TheMiz1os/WeatherStationV2/Project 3D Files and Models/adafruit-veml-7700-light-sensor-breakout-board-1.snapshot.2/VEML7700.jpg

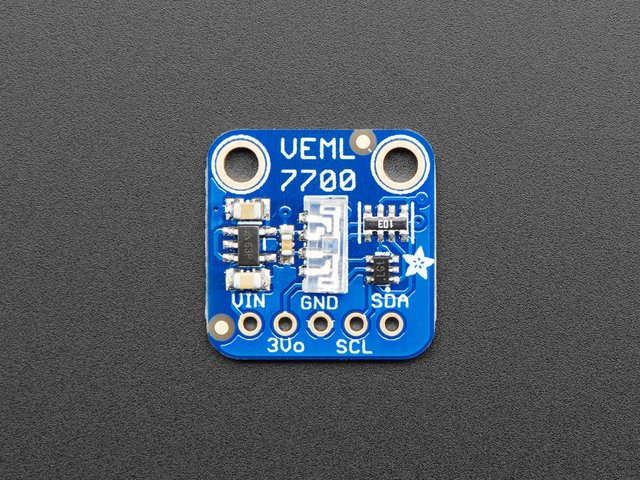
Project 3D Files and Models/adafruit-veml-7700-light-sensor-breakout-board-1.snapshot.2/VEML7700.jpg
