TheMiz1os/WeatherStationV2/Image References/Screenshot 2026-02-13 201124.png

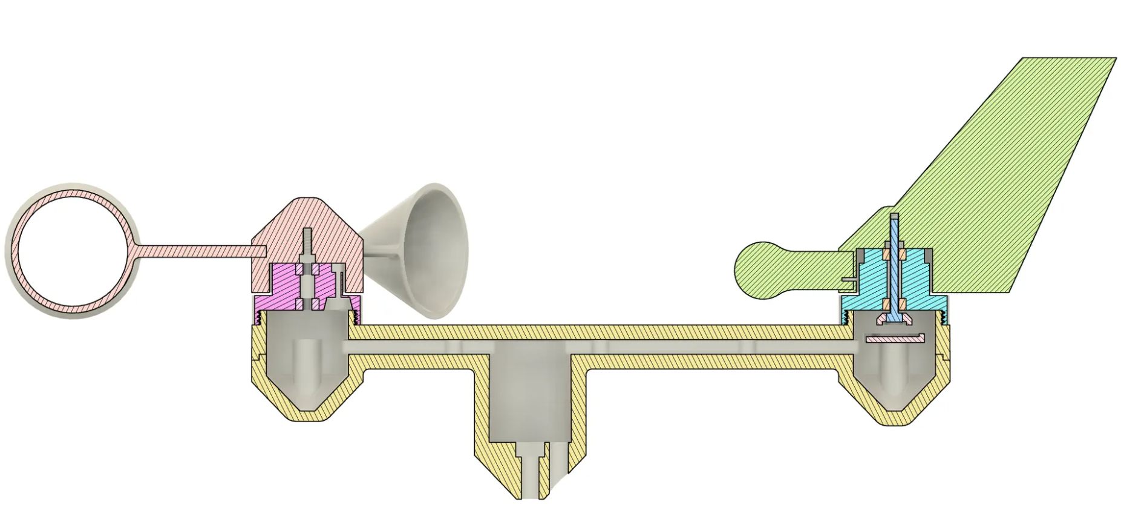
Image References/Screenshot 2026-02-13 201124.png
