TheMiz1os/WeatherStationV2/Project 3D Files and Models/weather-station-one-part-5/61764-weather-station-one-part-5.pdf

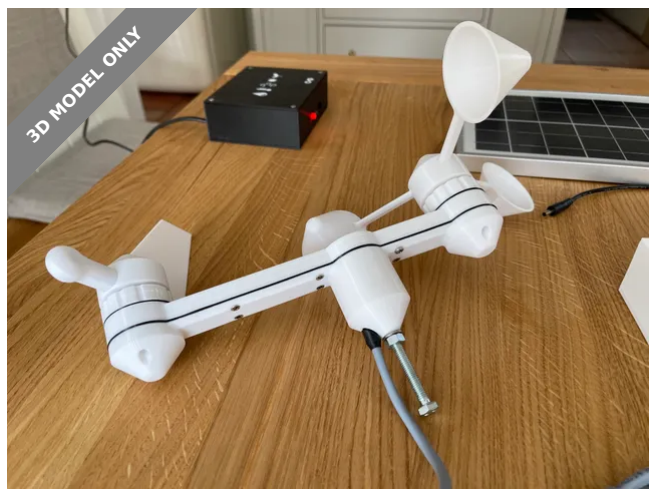
[picture p3: figure]
3D MODEL ONLY

## Summary

This is part 5 of a complete and modular weather station project. This is the wind vane and anemometer gauge part.

Gadgets (https://printables.com/model?categoryId=21) > Other Gadgets (https://printables.com/model?categoryId=43)

Tags: | sensor | temperature | humidity | wind | weather | rain
stevensonscreen | pressure | vane | anemometer | barometric

Overview on project

This is part of the Weather Station One project, a complete and modular weather station. The design of the system has been driven by a number of requirements:

collect all common weather channels including temperature, humidity, barometric pressure, rain, wind speed and direction, illumination / sun hours, ground humidity
modular design allowing one to implement part of it, or extend the range of sensors
high depth of production; DIY as much as possible

Harry (https://printables.com/@Harry)

## Weather Station One Part 5 - the Wind Vane and Anemometer

VIEW IN BROWSER (https://printables.com/model/61764-weather-station-one-part-5-the-wind-vane-and-anemo)

updated 1. 1. 2025 | published 1. 1. 2025

•

•

•

long range transmission support - with the point of measurement far from home
integration into a home automation system
functional, easy to print, and beautiful 3D design

When considering a project like this, please be aware that even with all designs published, it will be some work to do. This includes not only 3D printing, but carpentry work, soldering / electronics, and software in addition.

The parts published are made up from:

Part 1: Central Station. This is the part all sensors are connected to. It is battery / solar powered to allow placing it in the best place to measure data. It sends data collected using a HC-12 / 433Mhz band (up to 1 kilometer distance) chip.
Part 2: Base Station. This is the Central Station's counter part. It receives data using another HC-12 chip and is dispatching it to our home-automation system. In addition, it hosts a web server allowing direct access to weather data.
Part 3: Temperature (and other) sensor. This sensor is designed to sit in a proper Stevenson Screen / Wetterhütte. The current version measures ambient temperature, humidity, and barometric pressure using a digital sensor. It is connected to the Central Station.
Part 4: Rain Gauge. This is a rain gauge collecting rain and feeding it into commuting buckets. The number of commutes is measured using a reed contact triggered a bucket-moved magnet. It is connected to the Central Station.
Part 5: Wind Vane and Anemometer. Probably the most complex printing part measuring 16 wind directions and wind speed. Similar to the rain gauge, it is a mechanical part. Wind directions are measured using either 8 reed contacts, or an magnetic angle measurement sensor. Wind speed is measured by a single reed contact closed every time the anemometer wings do a full rotation. It is connected to the Central Station.
Part 6: Stevenson Screen / Wetterhütte. This part is not detailed further because we have built it based on a tutorial published by DWD (Deutscher Wetterdienst). As the tutorial has been removed from their site some time ago, you can find it as PDF file in Part 1: Central Station.
Part 7: optional Battery Pack. The solar module and charger chosen come with a mount for a 14500 sized Lithium battery. Depending on the power consumption of the Central Station (and sensors) you may want to use an external Battery Pack.
Part 8: Software and Electronics. This part is published on Github. (https://github.com/HarrysLapTimer/WeatherStationOne) Part 9: Solar Panel Mount. This is a solar panel mount as used currently. It allows adjusting the elevation to optimize generation for

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
Winter and Summer seasons. Mid term it will be replaced by a solar tracker following the sun azimuth.

For your convenience, I have created a WeatherStationOne (https://www.prusaprinters.org/social/92858-harry/collections/101642) collection including all but parts 6 and 8.

End of overview common to all parts.
Part 5 - Wind Vane and Anemometer

This combined sensor measures wind direction and wind speed.

19/2/2022 Update: added AS5600 Option

Wind direction using reeds

The initial version uses 8 reed contacts assembled as a ring to measure wind direction. A magnet moving with the vane triggers one, two, or three at a time. The two trigger situation in particular allows deriving 8 additional positions, resulting in 16 overall. So we do not only get N, NE, E, SE, S, SW, W, NW, but NNE, ENE, etc.

Using 8 reed contacts requires 8 wires plus one for VCC / GND contact. To reduce the number of wires, the electronic implementation adds a multiplexer chip into the wind mount. It allows Central Station to select one of the eight contacts, request its state, switch to the next and so on.

Overall, the multiplexing chip allows the reduction from 10 wires to 7 (see diagram), allowing us to utilize the 6 wire (plus shielding) cable we used throughout the project.

This option is named Reed Option in printing instructions.

New option! Wind direction using angle sensor

While the above version is working fine, mounting and soldering the 8 reed contacts on top of a multiplexer chip can be quite challenging. The second option presented here is based on a magnetic / inductive angle measurement sensor (AS5600) as proposed by a maker. It is the same low cost price class as the reeds and multiplexer.

The AS5600 features three interfaces, namely I2C, PWM, and analog output. While the former are better in general, they require more contacts and fine soldering (small contacts). As we use only 16 wind directions instead of degree or sub-degree measurements anyway, the current implementation uses the easy approach using the analog output and A2D conversion on the processing side.

This option is named the AS5600 Option in printing instructions.

Wind speed

Wind speed measurements using one reed is coming on top.

As most parts of Weather Station One, we use PETG filament. The 3D model includes seals to be printed using TPE or TPU filament. This is to keep the inner part of the wind sensors dry.

The anemometer requires calibration once it is assembled. The relation between axle rotations and wind speed can be set as a factor in the Central Station's ESP program.

Reed Option: handling 8 reed switches made of glass proved to be quite hard to keep functional during assembly. They need to be glued in and can break nevertheless. After two attempts to get a working combo, we switched to plastic body reeds. These are by far easier to handle and work fine.

AS5600 Option: this option requires hardware calibration; the magnet mount needs to be turned so the system reports North direction when VaneTip point to the N engraved in VaneMount. So the steps are: #1 glue magnet into MagnetMount, #2 press the mount on the screw - do not glue yet, #3 test direction and adjust mount, #4 once it matches, mark direction with a pencil and glue MagnetMount to the screw.

The wind mount has a M6 opening in the bottom to put it onto a threaded rod attached to the Stevenson Screen.

Printing configuration

Layer height 0.2mm
0.4mm nozzle
15% infill
White PETG filament
Black TPE / TPU filament
as shown in the PrusaSlicer files included, we this is printed in four jobs
job #1 - mount: turn the upper part upside down
job #2 - vane: place the tip of the vane vertical; tip with 100% for weight balancing; this job differs depending on whether Reed Option or AS5600 Option is implemented
job #3 - anemometer: print 3 cups, and place them with the open side down
job #4 - seals: as is
automatic support (from building plate only)

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
## Model files

Other parts needed

4x miniature steel bearing 3x8x4mm
2x long M3 screws or a M3 threaded rod to shorten for both axles 14x M3x10 screws
1x glass reed contact 2x14mm for anemometer (buy more, they break easily)
Reed Option: 8x plastic reed contacts 3x14mm for wind vane Reed Option: 1 x HC4051 multiplexer chip
2x magnet 4x1mm (buy some more for fine tuning)
AS5600 Option: 1x AS5600 sensor - version soldered to a “round” PCB
AS5600 Option: 1x diametrically magnetized neodymium magnet 8x1mm
cable to run from wind mount to central station, outer diameter 4.7mm
1x MiniDIN (PS/2) 6 pin plug (shielding used as 7th wire)
2x M6 nut for the base and as counter nut
1x M6 threaded rod to as a mount to the Stevenson Screen

Closing

This is another free 3D model made available for you. Designing, testing, preparing, uploading and maintaining my models is effort. In case you enjoy them, please send a donation using the coin button in the top right. Thanks a lot!

## This remix is based on

- PrusaSlicer file for job #4

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
windseals.3mf

- PrusaSlicer file for job #3
- PrusaSlicer file for job #2 for Reed Option
- PrusaSlicer file for job #2 for AS5600 Option
- PrusaSlicer file for job #1
- print 3 times
- used by Reed Option

anemometer.3mf

vanereedoption.3mf

vaneas5600option.3mf

windmount.3mf

windvaneseal.stl

anemoflyer.stl

mainseal.stl

vanereedmount.stl

anemoreedmount.stl

anemoflyersmount.stl

- Print with the flat side down and 100% infill (weight distribution)
- used by AS5600 Option
- used by AS5600 Option
- used by AS5600 Option

Find source .stl files on Thingiverse.com (http://downloads.gps-laptimer.de/WeatherStation.f3d)

## License

This work is licensed under a
Creative Commons (4.0 International License)

Attribution (http://creativecommons.org/licenses/by/4.0/)

vanetip.stl

vane.stl

windmountbottom.stl

windmounttop.stl

sensormount.stl

magnetmount.stl

vanemount.stl

✖ | Sharing without ATTRIBUTION
✔ | Remix Culture allowed
✔ | Commercial Use
✔ | Free Cultural Works
✔ | Meets Open Definition
