TheMiz1os/WeatherStationV2/3D Files/Main Assembly v28.3mf

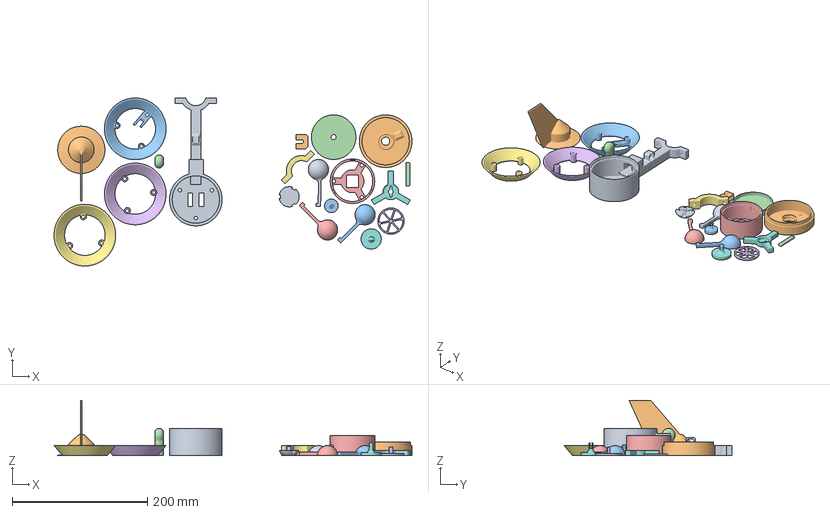
[picture p4: CAD file, 2026-01-24]
3D Files/Main Assembly v28.3mf
530.1 x 248.8 x 82.0 mm
Main Body
Top
Sensor Housing
Beaing Holder
Bowl 3
Vane
Bowl 2
VaneTip.stl
Bowl 1
Cunter-Holder
Shaft x 2
Cap
Magnet Holder
