TheMiz1os/WeatherStationV2/Project 3D Files and Models/cjmcu-680-bme680/CJMCU-680, BME680 Ambient Temperature, Relative Humidity, Barometric Pressure, and Gas VOC Sensor.SLDASM

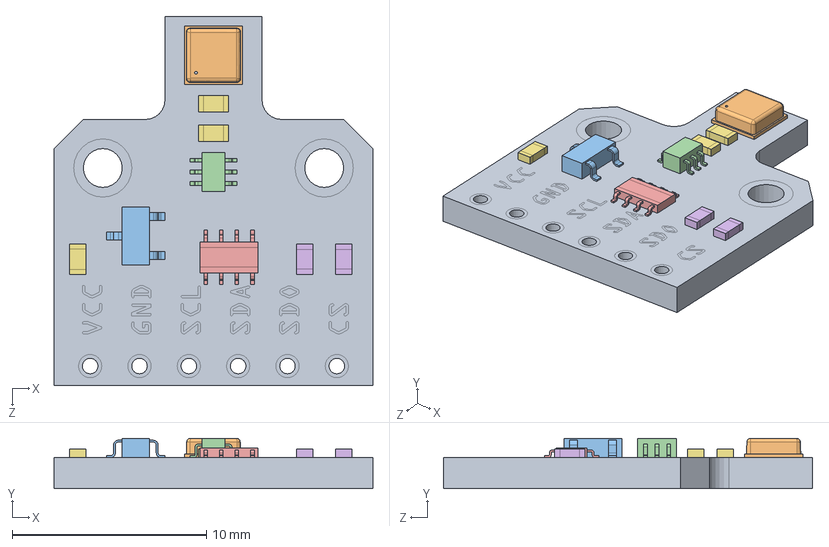
[picture p5: CAD file, 2026-01-24]
Project 3D Files and Models/cjmcu-680-bme680/CJMCU-680, BME680 Ambient Temperature, Relative Humidity, Barometric Pressure, and Gas VOC Sensor.SLDASM
16.4 x 2.60 x 19.0 mm
PCB, CJMCU-680, BME680 Ambient Temperature, Relative Humidity, Barometric Pressure, and Gas VOC Sensor
Sensor Module, CJMCU-680, BME680 Ambient Temperature, Relative Humidity, Barometric Pressure, and Gas VOC Sensor
3.3V LDO Regulator, CJMCU-680, BME680 Ambient Temperature, Relative Humidity, Barometric Pressure, and Gas VOC Sensor
Level Signal Conversion Chip, CJMCU-680, BME680 Ambient Temperature, Relative Humidity, Barometric Pressure, and Gas VOC Sensor
8 Legs SMD Component, CJMCU-680, BME680 Ambient Temperature, Relative Humidity, Barometric Pressure, and Gas VOC Sensor
SMD Resistor, Configurable, CJMCU-680, BME680 Ambient Temperature, Relative Humidity, Barometric Pressure, and Gas VOC Sensor x 2
SMD Capacitor, Configurable, CJMCU-680, BME680 Ambient Temperature, Relative Humidity, Barometric Pressure, and Gas VOC Sensor x 3
