TheMiz1os/WeatherStationV2/3D Models/SOT-23-6.step

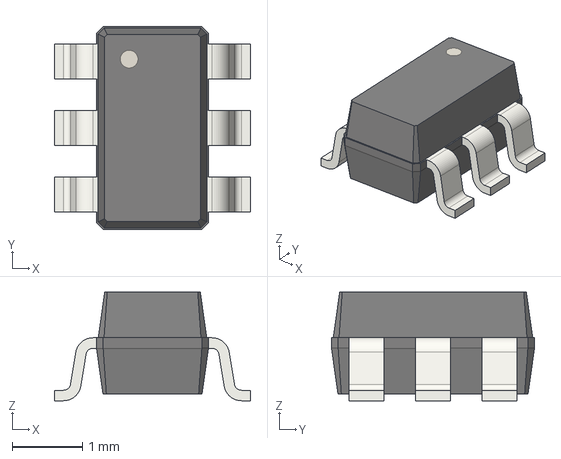
[picture p7: CAD file, 2026-08-27]
3D Models/SOT-23-6.step
2.80 x 2.90 x 1.55 mm
