TheMiz1os/WeatherStationV2/_Secondary board/Secondary Board.step

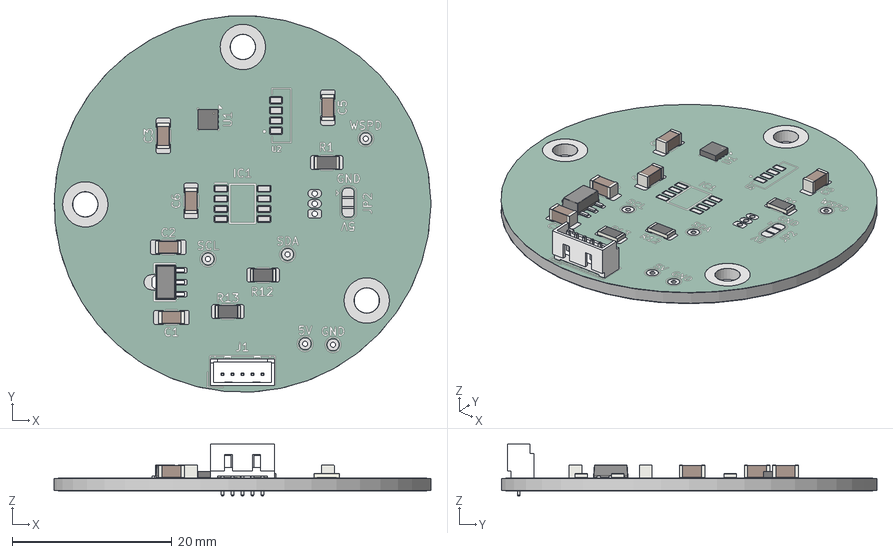
[picture p8: CAD file, 2026-02-16]
_Secondary board/Secondary Board.step
47.2 x 47.1 x 6.48 mm
JST - GH - Thru (V) - 5Pin - 1.25mm
R_1206_3216Metric x 3
C_1206_3216Metric x 5
SOT-89-3_L4.5-W2.5-P1.50-LS4.2-BR
Bosch_LGA-8_2.5x2.5mm_P0.65mm_ClockwisePinNumbering
Secondary Board_copper
Secondary Board_pad
Secondary Board_via
Secondary Board_silkscreen x 2
Secondary Board_soldermask x 2
Secondary Board_PCB
