TheMiz1os/WeatherStationV2/Project 3D Files and Models/adafruit-veml-7700-light-sensor-breakout-board-1.snapshot.2/Adafruit VEML 7700 Light Sensor Breakout Board.STEP

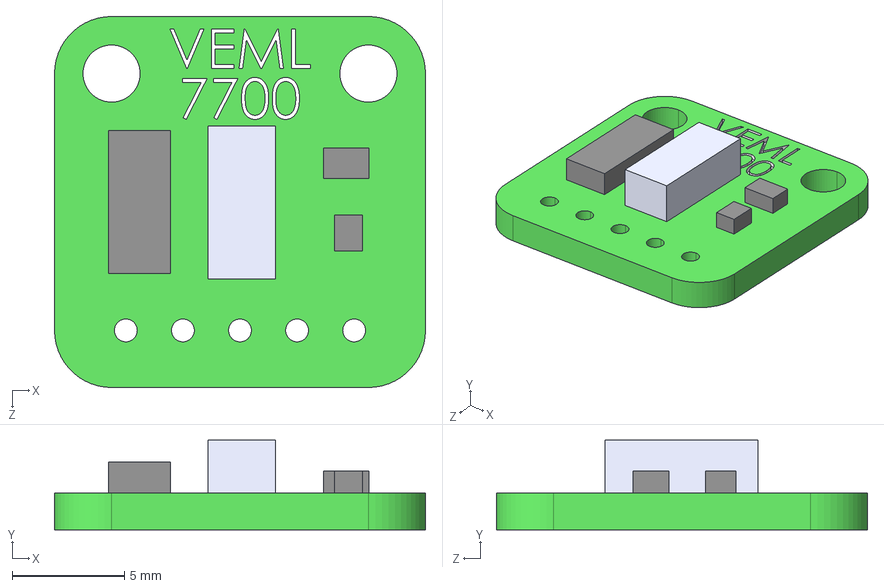
[picture p9: CAD file, 2026-02-12]
Project 3D Files and Models/adafruit-veml-7700-light-sensor-breakout-board-1.snapshot.2/Adafruit VEML 7700 Light Sensor Breakout Board.STEP
16.5 x 4.00 x 16.5 mm
