TheMiz1os/WeatherStationV2/Project 3D Files and Models/cjmcu-680-bme680/SMD Resistor, Configurable, CJMCU-680, BME680 Ambient Temperature, Relative Humidity, Barometric Pressure, and Gas VOC Sensor.SLDPRT

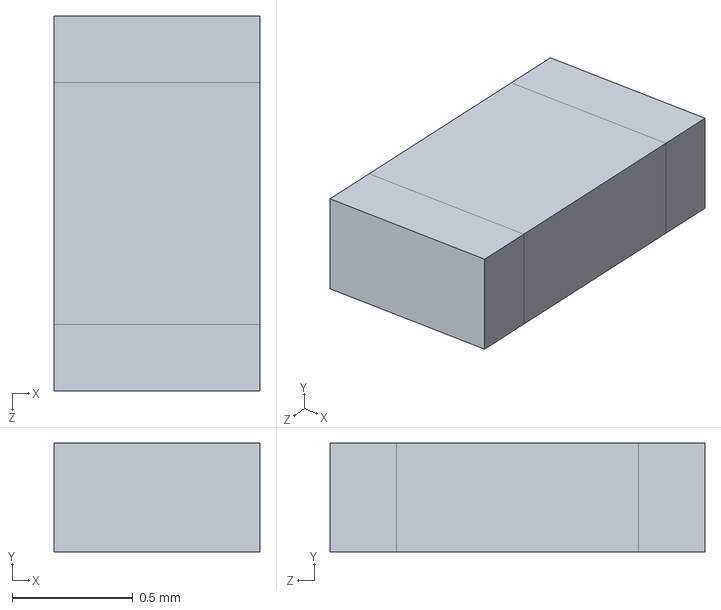
[picture p10: CAD file, 2026-01-24]
Project 3D Files and Models/cjmcu-680-bme680/SMD Resistor, Configurable, CJMCU-680, BME680 Ambient Temperature, Relative Humidity, Barometric Pressure, and Gas VOC Sensor.SLDPRT
0.85 x 0.45 x 1.55 mm
