TheMiz1os/WeatherStationV2/Project 3D Files and Models/weather-station-one-part-5/Vane.stl

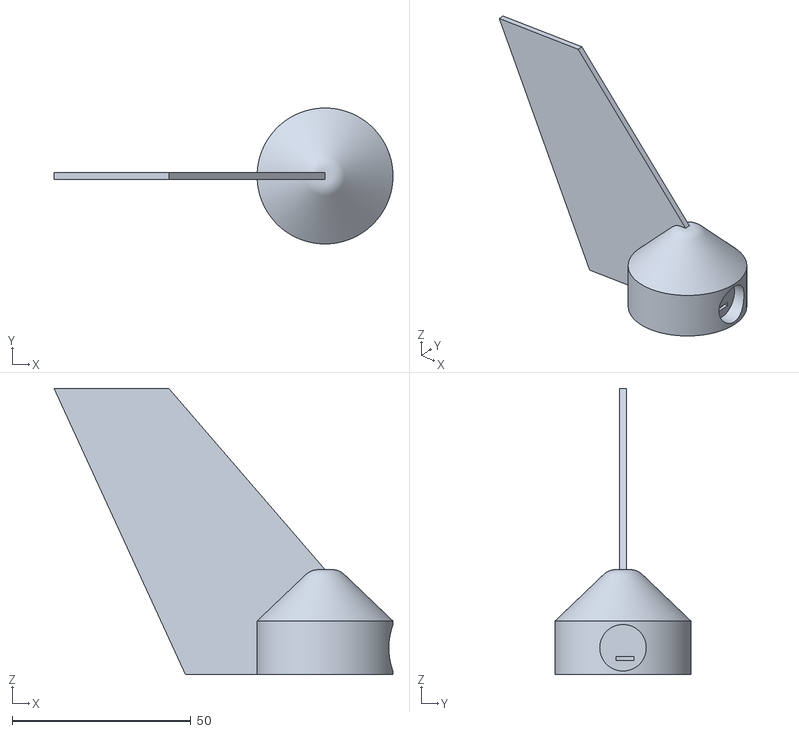
[picture p12: CAD file, 2026-01-24]
Project 3D Files and Models/weather-station-one-part-5/Vane.stl
94.8 x 38.0 x 80.0
