TheMiz1os/WeatherStationV2/Project 3D Files/board.step

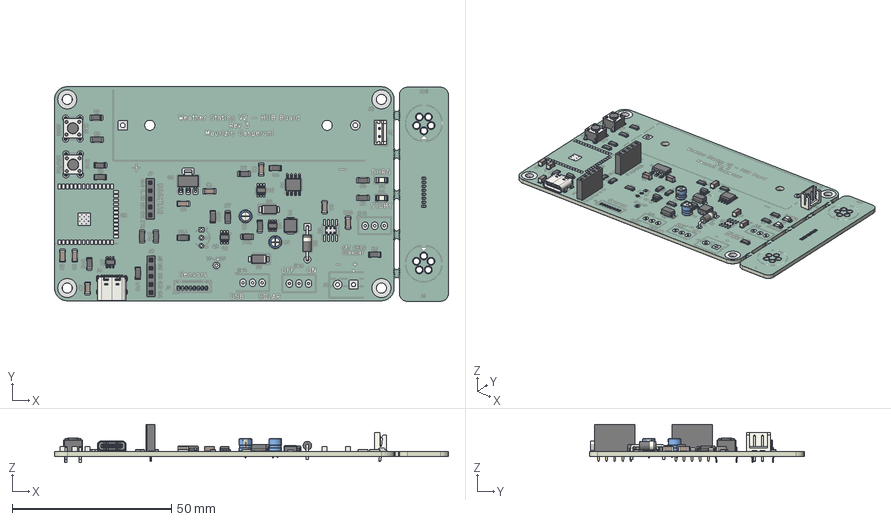
[picture p13: CAD file, 2026-10-16]
Project 3D Files/board.step
123.5 x 67.3 x 12.0 mm
C_1206_3216Metric x 8
SOT-23-6 x 4
R_1206_3216Metric x 18
CP_Radial_D4.0mm_P1.50mm x 2
SW_PUSH_6mm x 2
SOIC-8_3.9x4.9mm_P1.27mm
PinSocket_1x05_P2.54mm_Vertical x 2
LED_1206_3216Metric x 2
D_DO-41_SOD81_P10.16mm_Horizontal
D_SMA x 2
JST_EH_B2B-EH-A_1x02_P2.50mm_Vertical
SOT-223
USB_C_Receptacle_GCT_USB4105-xx-A_16P_TopMnt_Horizontal
L_APV_APH0420
Weather Station V2_copper
Weather Station V2_pad
Weather Station V2_via
Weather Station V2_silkscreen x 2
Weather Station V2_soldermask x 2
Weather Station V2_PCB
