TheMiz1os/WeatherStationV2/3D Models/JST_EH_B2B-EH-A_1x02_P2.50mm_Vertical.step

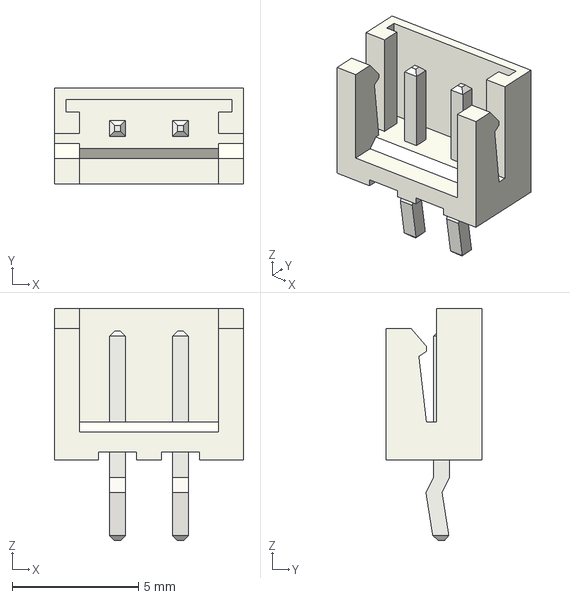
[picture p14: CAD file, 2026-08-27]
3D Models/JST_EH_B2B-EH-A_1x02_P2.50mm_Vertical.step
7.50 x 3.80 x 9.20 mm
