TheMiz1os/WeatherStationV2/Project 3D Files and Models/cjmcu-680-bme680/8 Legs SMD Component, CJMCU-680, BME680 Ambient Temperature, Relative Humidity, Barometric Pressure, and Gas VOC Sensor.SLDPRT

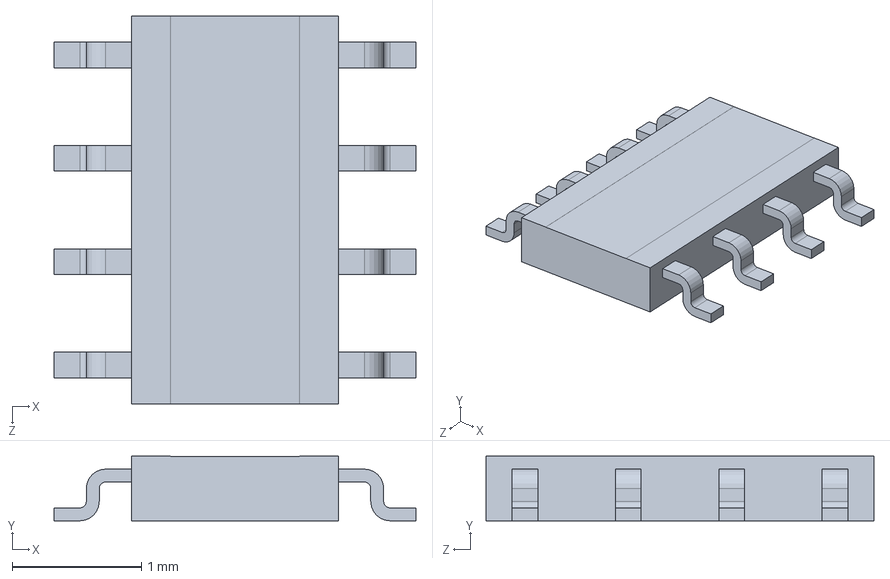
[picture p15: CAD file, 2026-01-24]
Project 3D Files and Models/cjmcu-680-bme680/8 Legs SMD Component, CJMCU-680, BME680 Ambient Temperature, Relative Humidity, Barometric Pressure, and Gas VOC Sensor.SLDPRT
2.80 x 0.5 x 3.00 mm
