TheMiz1os/WeatherStationV2/Project 3D Files and Models/weather-station-one-part-5/WindSeals.3mf

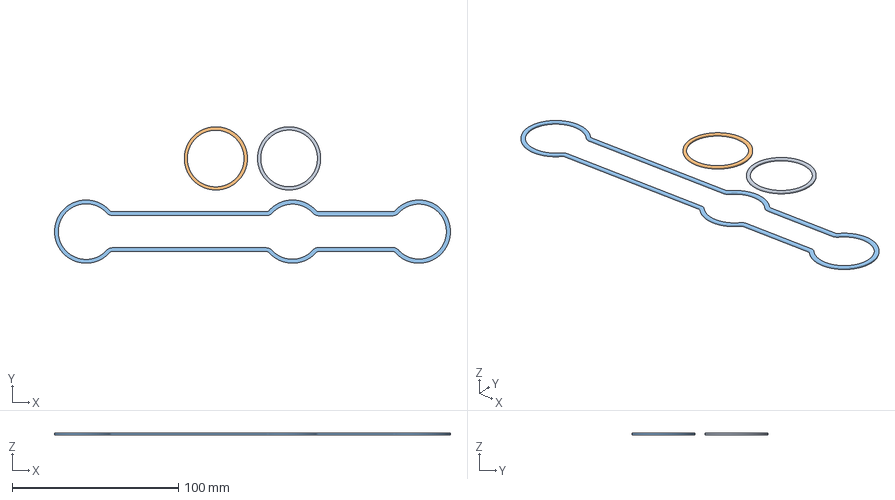
[picture p16: CAD file, 2026-01-24]
Project 3D Files and Models/weather-station-one-part-5/WindSeals.3mf
238.0 x 82.0 x 1.00 mm
AnemoSeal.stl
WindVaneSeal.stl
MainSeal.stl
