TheMiz1os/WeatherStationV2/Project 3D Files/cjmcu-680-bme680/3.3V LDO Regulator, CJMCU-680, BME680 Ambient Temperature, Relative Humidity, Barometric Pressure, and Gas VOC Sensor.SLDPRT

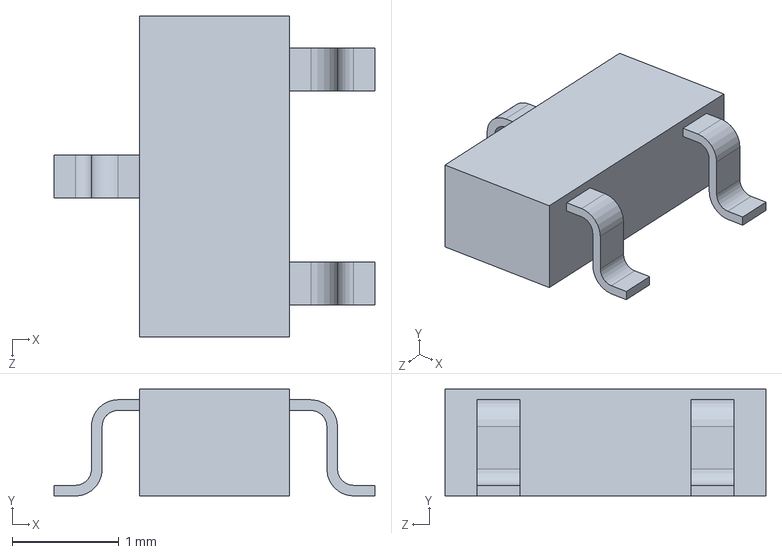
[picture p17: CAD file, 2026-01-24]
Project 3D Files/cjmcu-680-bme680/3.3V LDO Regulator, CJMCU-680, BME680 Ambient Temperature, Relative Humidity, Barometric Pressure, and Gas VOC Sensor.SLDPRT
3.00 x 1.00 x 3.00 mm
