TheMiz1os/WeatherStationV2/Project 3D Files/Sensor Hub.3mf

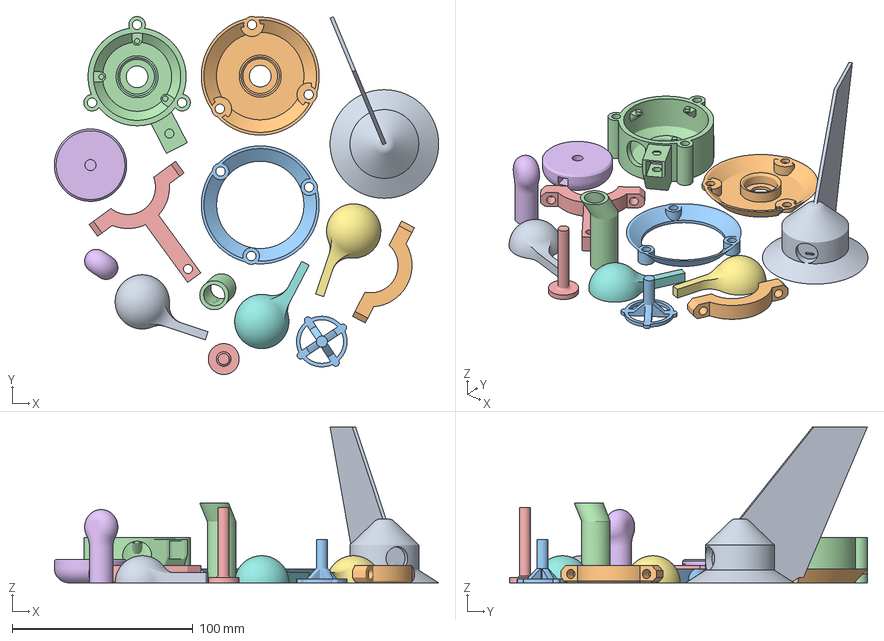
[picture p18: CAD file, 2026-10-16]
Project 3D Files/Sensor Hub.3mf
212.4 x 197.8 x 86.0 mm
Vane
Screen 2
Screen 1
Enclosure
Arm
Bottom Cap
Spoon 1 (1)
Spoon 1 (2)
Spoon 1
Bracket
Centre Wheel
Cable Tube
Centre Rod
VaneTip
