TheMiz1os/WeatherStationV2/3D Models/SOIC-8_3.9x4.9mm_P1.27mm.step

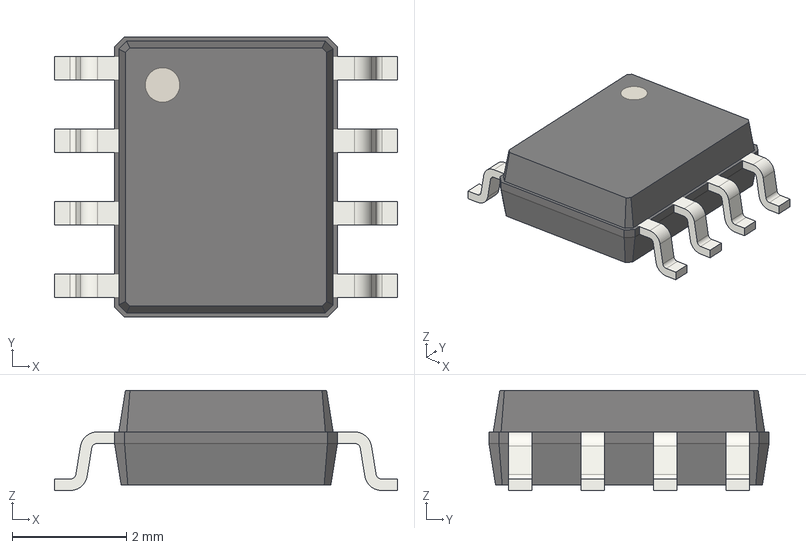
[picture p19: CAD file, 2026-08-27]
3D Models/SOIC-8_3.9x4.9mm_P1.27mm.step
6.00 x 4.90 x 1.75 mm
