TheMiz1os/WeatherStationV2/Project 3D Files and Models/cjmcu-680-bme680/Sensor Module, CJMCU-680, BME680 Ambient Temperature, Relative Humidity, Barometric Pressure, and Gas VOC Sensor.SLDPRT

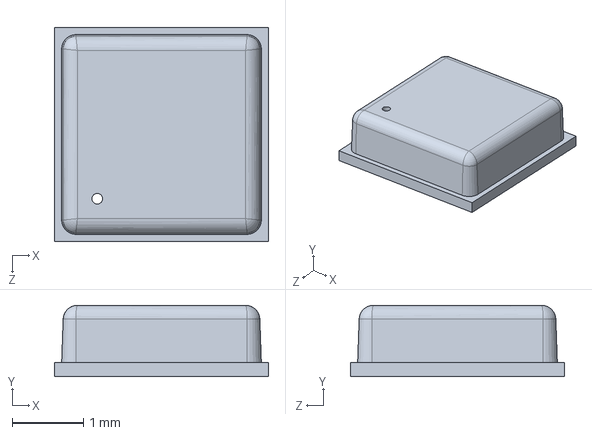
[picture p20: CAD file, 2026-01-24]
Project 3D Files and Models/cjmcu-680-bme680/Sensor Module, CJMCU-680, BME680 Ambient Temperature, Relative Humidity, Barometric Pressure, and Gas VOC Sensor.SLDPRT
3.00 x 1.00 x 3.00 mm
