TheMiz1os/WeatherStationV2/Project 3D Files and Models/weather-station-one-part-5/WindMountTop.stl

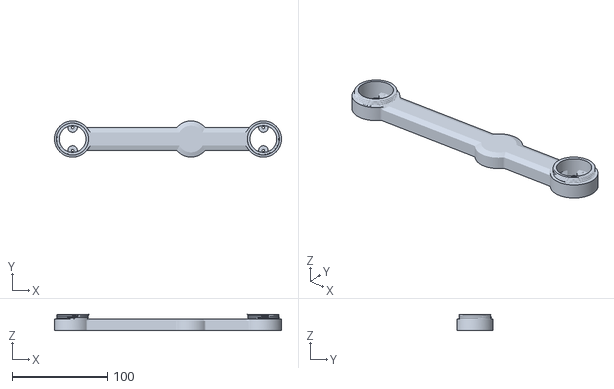
[picture p21: CAD file, 2026-01-24]
Project 3D Files and Models/weather-station-one-part-5/WindMountTop.stl
238.0 x 38.0 x 17.0
