TheMiz1os/WeatherStationV2/Project 3D Files/cjmcu-680-bme680/Level Signal Conversion Chip, CJMCU-680, BME680 Ambient Temperature, Relative Humidity, Barometric Pressure, and Gas VOC Sensor.SLDPRT

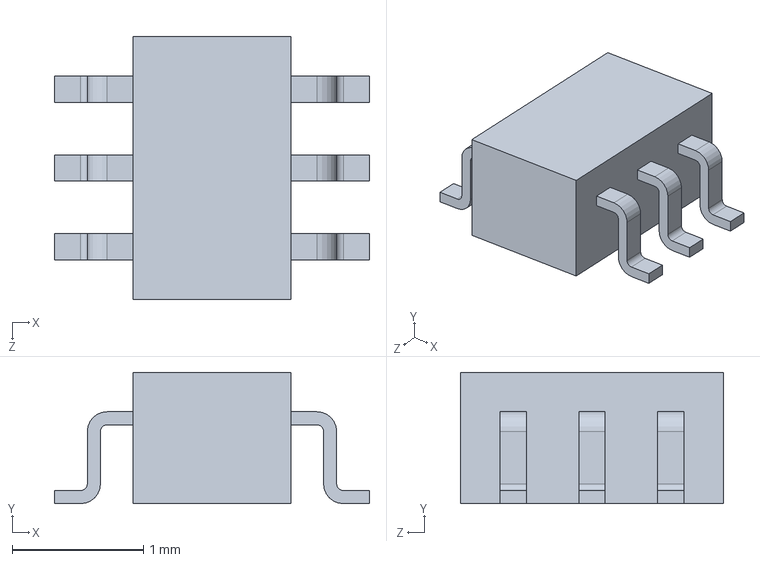
[picture p22: CAD file, 2026-01-24]
Project 3D Files/cjmcu-680-bme680/Level Signal Conversion Chip, CJMCU-680, BME680 Ambient Temperature, Relative Humidity, Barometric Pressure, and Gas VOC Sensor.SLDPRT
2.40 x 1.00 x 2.00 mm
