TheMiz1os/WeatherStationV2/Project 3D Files/M-RJHSE-538X-REVT1.STEP

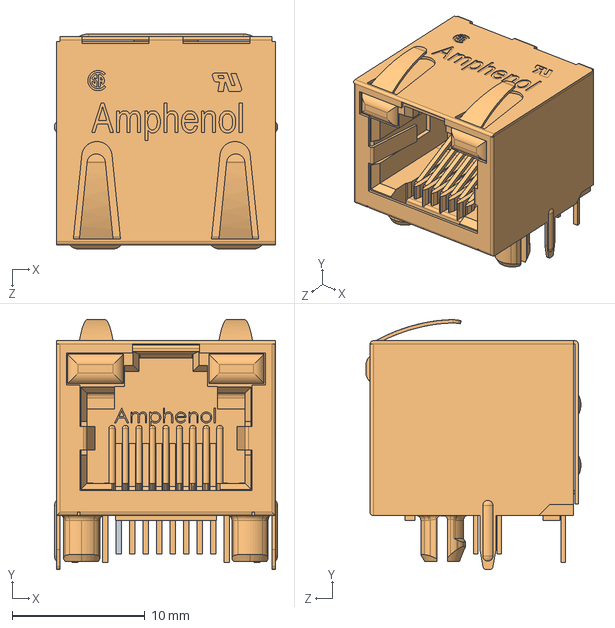
[picture p23: CAD file, 2026-10-01]
Project 3D Files/M-RJHSE-538X-REVT1.STEP
16.8 x 18.8 x 16.2 mm
