TheMiz1os/WeatherStationV2/3D Models/L_APV_APH0420.step

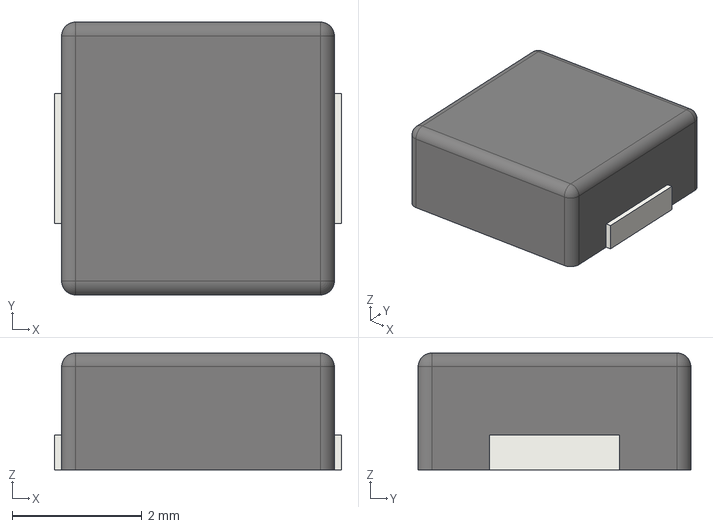
[picture p24: CAD file, 2026-08-27]
3D Models/L_APV_APH0420.step
4.42 x 4.20 x 1.80 mm
