TheMiz1os/WeatherStationV2/Project 3D Files and Models/weather-station-one-part-5/MagnetMount.stl

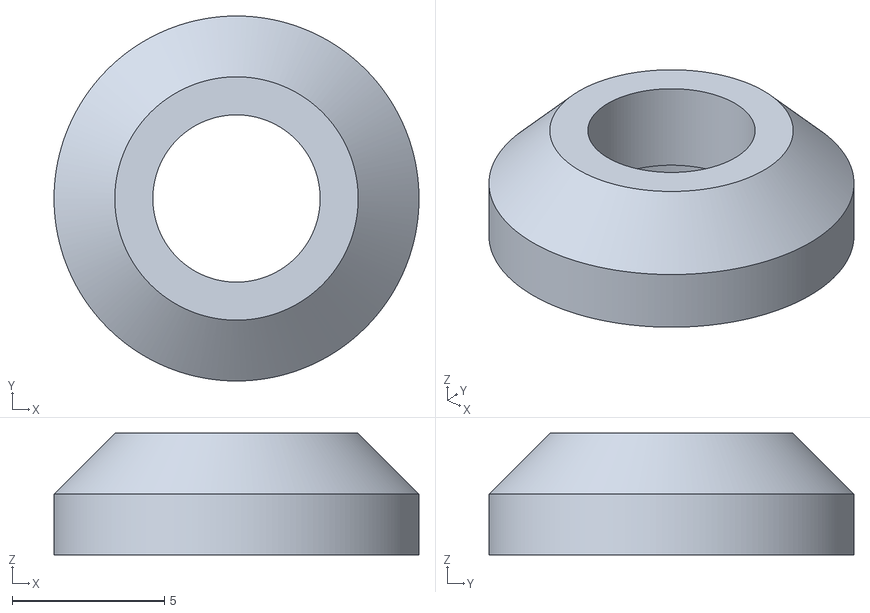
[picture p25: CAD file, 2026-01-24]
Project 3D Files and Models/weather-station-one-part-5/MagnetMount.stl
12.0 x 12.0 x 4.00
