TheMiz1os/WeatherStationV2/Project 3D Files/AS5600.step

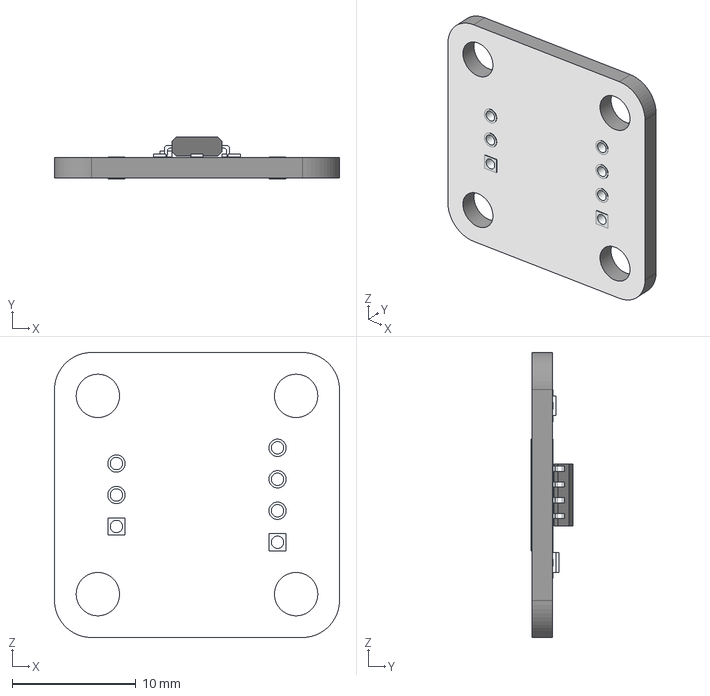
[picture p26: CAD file, 2026-01-24]
Project 3D Files/AS5600.step
23.0 x 3.35 x 23.0 mm
