TheMiz1os/WeatherStationV2/Project 3D Files/cjmcu-680-bme680/PCB, CJMCU-680, BME680 Ambient Temperature, Relative Humidity, Barometric Pressure, and Gas VOC Sensor.SLDPRT

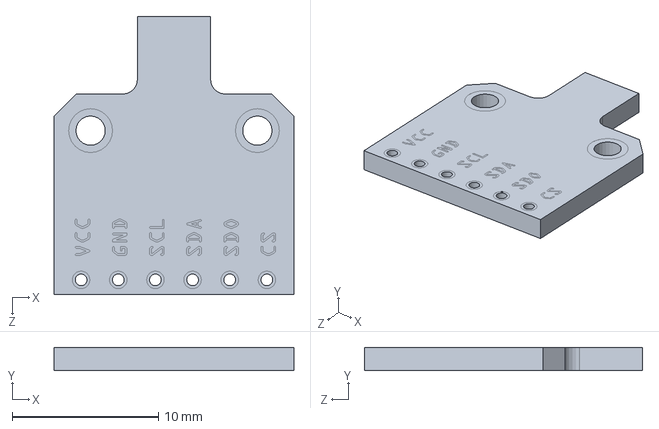
[picture p27: CAD file, 2026-01-24]
Project 3D Files/cjmcu-680-bme680/PCB, CJMCU-680, BME680 Ambient Temperature, Relative Humidity, Barometric Pressure, and Gas VOC Sensor.SLDPRT
16.4 x 1.60 x 19.0 mm
