TheMiz1os/WeatherStationV2/3D Models/USB_C_Receptacle_GCT_USB4105-xx-A_16P_TopMnt_Horizontal.step

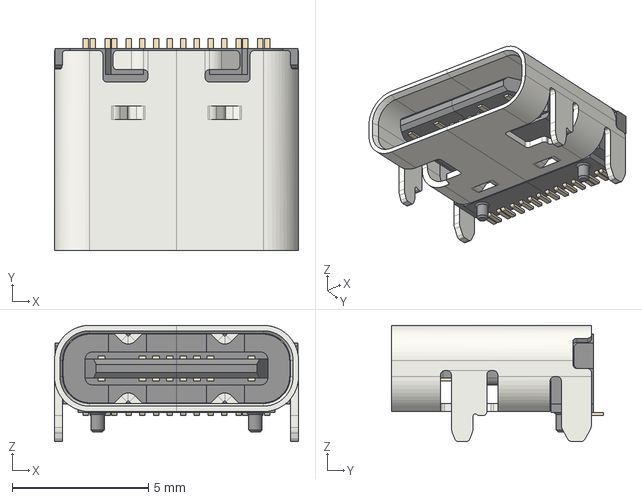
[picture p28: CAD file, 2026-08-27]
3D Models/USB_C_Receptacle_GCT_USB4105-xx-A_16P_TopMnt_Horizontal.step
8.94 x 7.78 x 4.26 mm
