TheMiz1os/WeatherStationV2/Project 3D Files and Models/weather-station-one-part-5/AnemoReedMount.stl

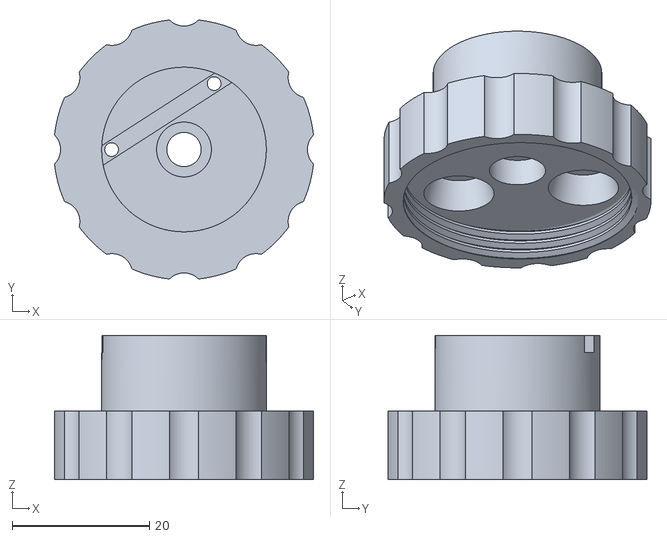
[picture p29: CAD file, 2026-01-24]
Project 3D Files and Models/weather-station-one-part-5/AnemoReedMount.stl
37.8 x 37.8 x 21.0
