TheMiz1os/WeatherStationV2/3D Models/PinSocket_1x05_P2.54mm_Vertical.step

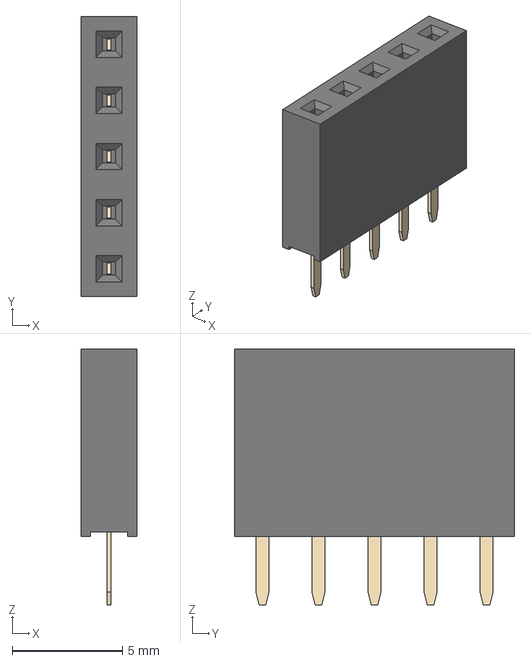
[picture p30: CAD file, 2026-08-27]
3D Models/PinSocket_1x05_P2.54mm_Vertical.step
2.54 x 12.7 x 11.6 mm
