TheMiz1os/WeatherStationV2/Project 3D Files and Models/weather-station-one-part-5/WindMount.3mf

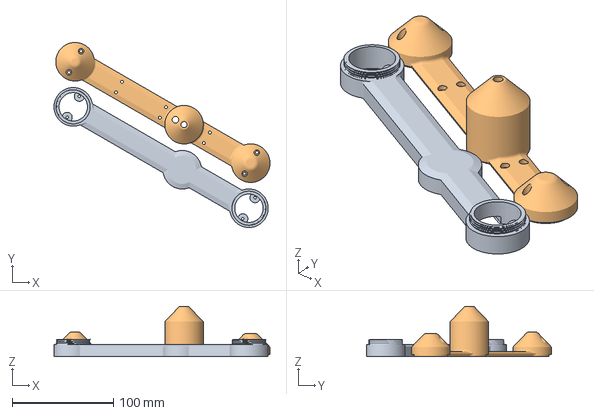
[picture p31: CAD file, 2026-01-24]
Project 3D Files and Models/weather-station-one-part-5/WindMount.3mf
213.0 x 182.4 x 49.3 mm
WindMountTop.stl
WindMountBottom.stl
