TheMiz1os/WeatherStationV2/3D Models/LED_1206_3216Metric.step

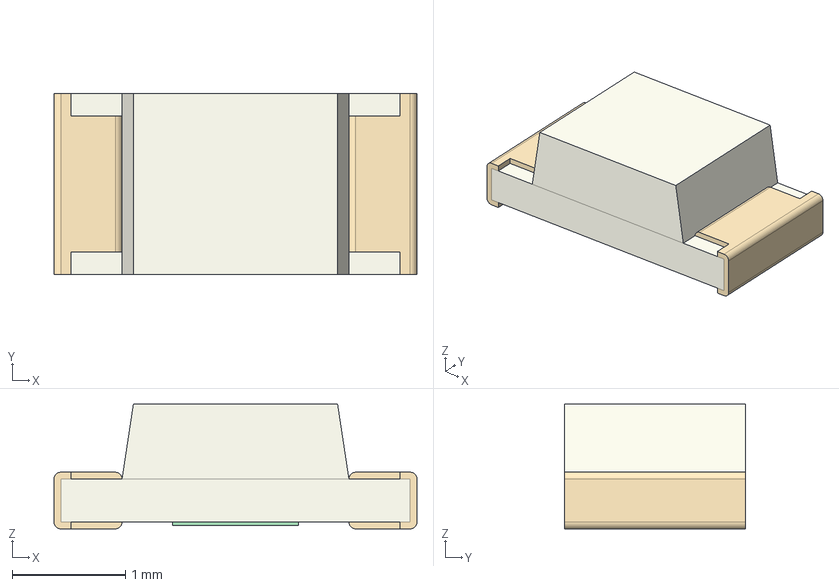
[picture p32: CAD file, 2026-08-27]
3D Models/LED_1206_3216Metric.step
3.20 x 1.60 x 1.10 mm
