TheMiz1os/WeatherStationV2/Project 3D Files and Models/weather-station-one-part-5/VaneAS5600Option.3mf

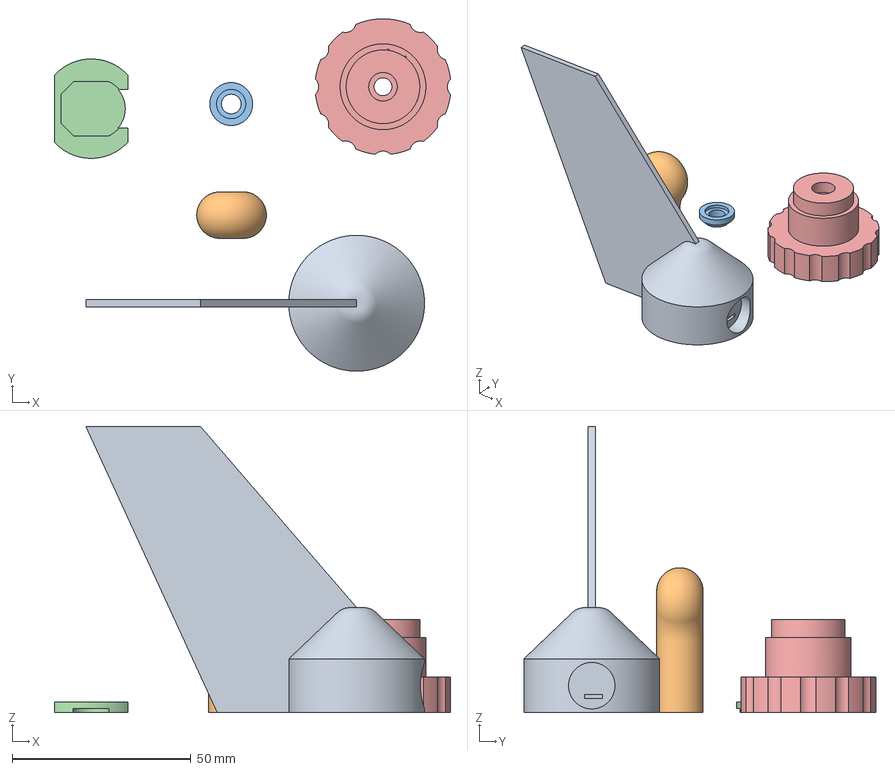
[picture p33: CAD file, 2026-01-24]
Project 3D Files and Models/weather-station-one-part-5/VaneAS5600Option.3mf
110.8 x 98.6 x 80.0 mm
Vane.stl
VaneTip.stl
MagnetMount.stl
SensorMount.stl
VaneMount.stl
