TheMiz1os/WeatherStationV2/3D Models/D_DO-41_SOD81_P10.16mm_Horizontal.step

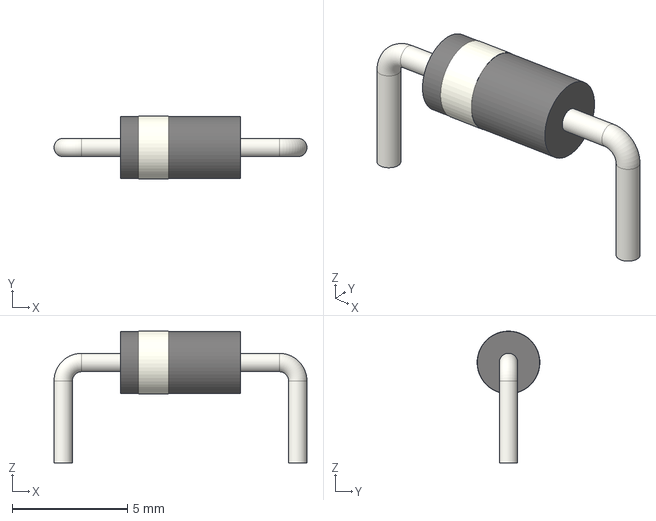
[picture p34: CAD file, 2026-08-27]
3D Models/D_DO-41_SOD81_P10.16mm_Horizontal.step
11.0 x 2.72 x 5.71 mm
