TheMiz1os/WeatherStationV2/Project 3D Files and Models/weather-station-one-part-5/VaneTip.stl

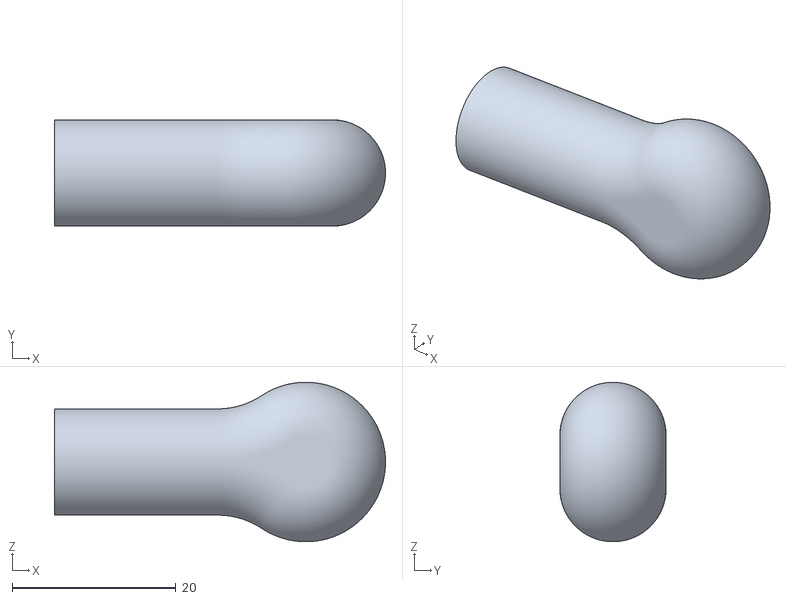
[picture p35: CAD file, 2026-01-24]
Project 3D Files and Models/weather-station-one-part-5/VaneTip.stl
40.5 x 13.0 x 19.5
