TheMiz1os/WeatherStationV2/3D Models/R_1206_3216Metric.step

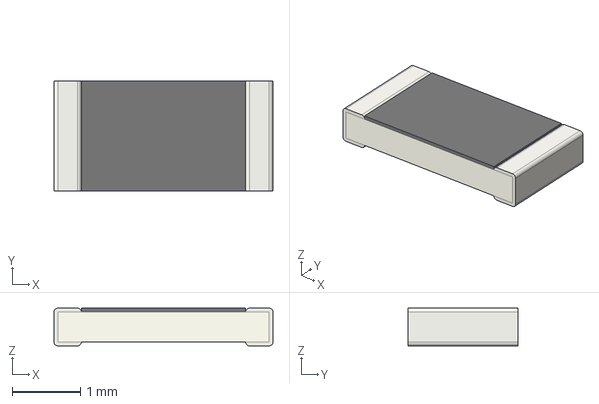
[picture p36: CAD file, 2026-08-27]
3D Models/R_1206_3216Metric.step
3.20 x 1.60 x 0.55 mm
