TheMiz1os/WeatherStationV2/Project 3D Files and Models/weather-station-one-part-5/SensorMount.stl

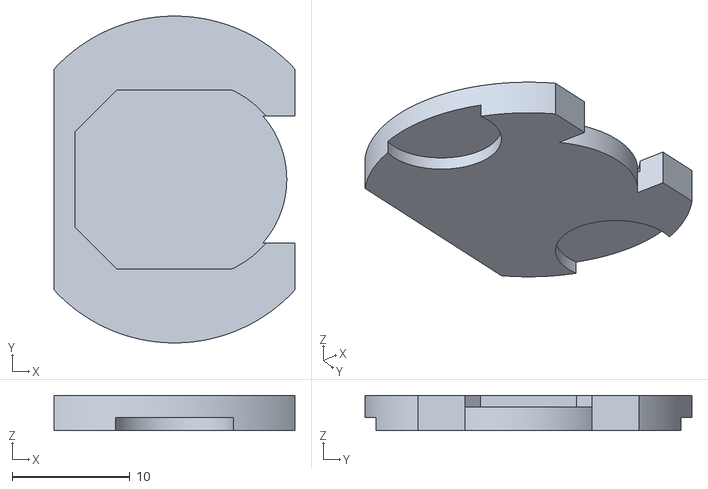
[picture p37: CAD file, 2026-01-24]
Project 3D Files and Models/weather-station-one-part-5/SensorMount.stl
20.5 x 27.8 x 3.00
