TheMiz1os/WeatherStationV2/3D Models/CP_Radial_D4.0mm_P1.50mm.step

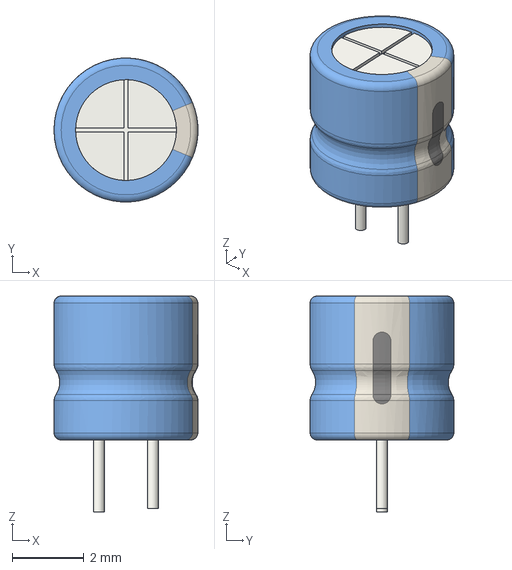
[picture p38: CAD file, 2026-08-27]
3D Models/CP_Radial_D4.0mm_P1.50mm.step
4.00 x 4.00 x 6.00 mm
