TheMiz1os/WeatherStationV2/3D Models/ESP32-S3-WROOM-1.step

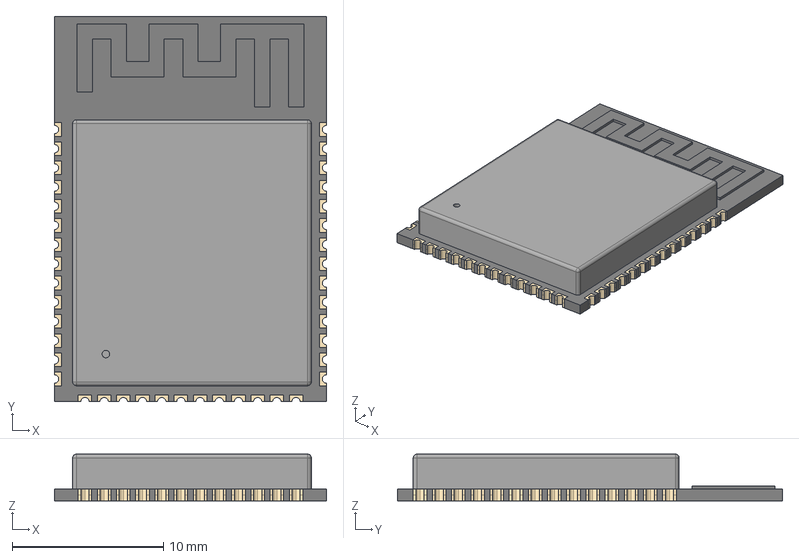
[picture p40: CAD file, 2026-08-27]
3D Models/ESP32-S3-WROOM-1.step
18.0 x 25.5 x 3.10 mm
