TheMiz1os/WeatherStationV2/Project 3D Files and Models/weather-station-one-part-5/VaneMount.stl

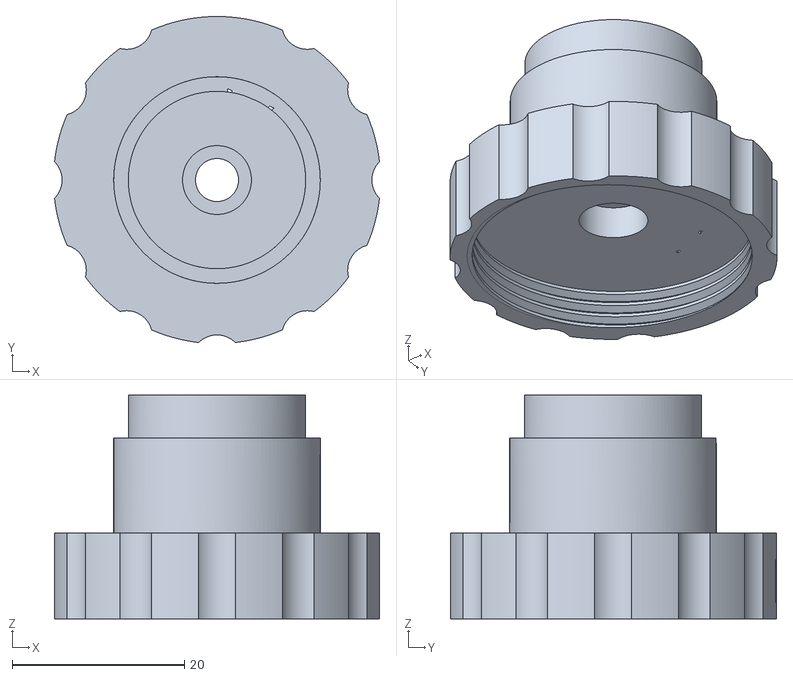
[picture p41: CAD file, 2026-01-24]
Project 3D Files and Models/weather-station-one-part-5/VaneMount.stl
37.8 x 37.9 x 26.0
