TheMiz1os/WeatherStationV2/Project 3D Files and Models/weather-station-one-part-5/WindMountBottom.stl

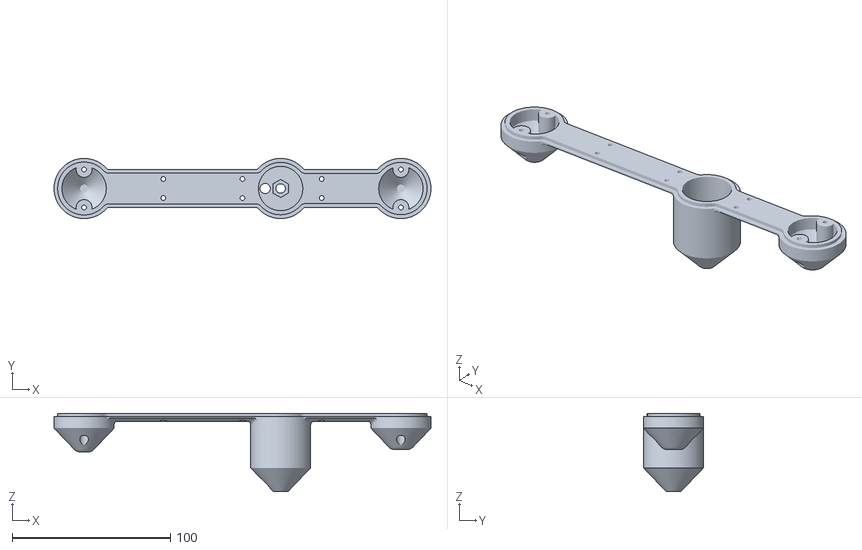
[picture p43: CAD file, 2026-01-24]
Project 3D Files and Models/weather-station-one-part-5/WindMountBottom.stl
238.0 x 38.0 x 49.3
