TheMiz1os/WeatherStationV2/3D Models/SW_PUSH_6mm.step

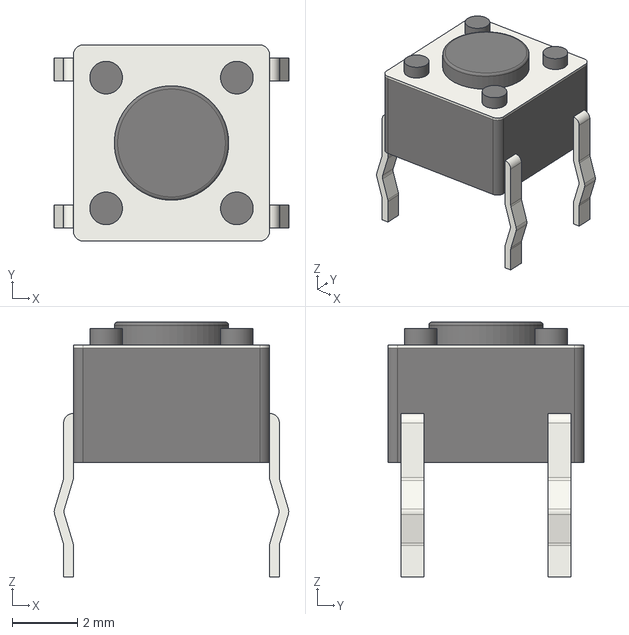
[picture p44: CAD file, 2026-08-27]
3D Models/SW_PUSH_6mm.step
7.17 x 6.00 x 7.80 mm
