TheMiz1os/WeatherStationV2/Project 3D Files and Models/weather-station-one-part-5/VaneReedOption.3mf

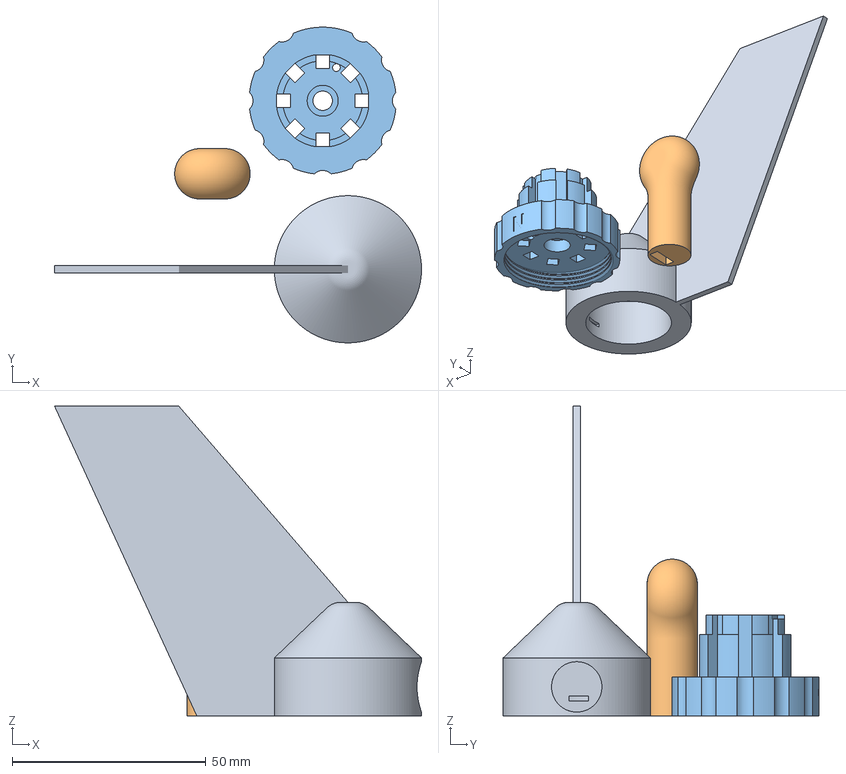
[picture p45: CAD file, 2026-01-24]
Project 3D Files and Models/weather-station-one-part-5/VaneReedOption.3mf
94.8 x 81.5 x 80.0 mm
Vane.stl
VaneTip.stl
VaneReedMount.stl
