TheMiz1os/WeatherStationV2/3D Models/C_Disc_D3.0mm_W2.0mm_P2.50mm.step

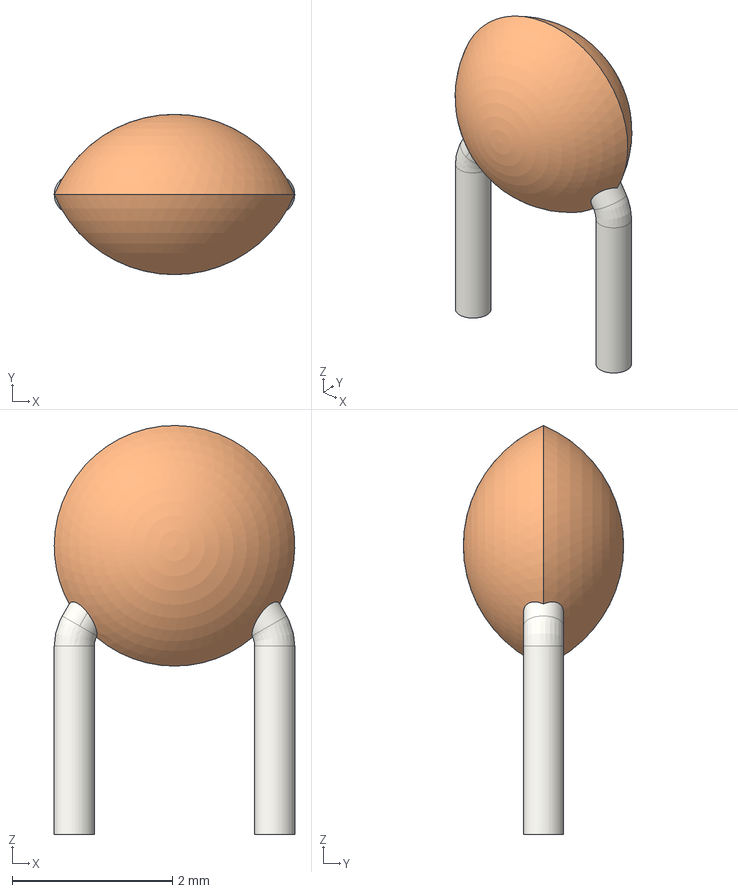
[picture p46: CAD file, 2026-08-27]
3D Models/C_Disc_D3.0mm_W2.0mm_P2.50mm.step
3.00 x 2.00 x 5.10 mm
