TheMiz1os/WeatherStationV2/3D Models/Bosch_LGA-8_2.5x2.5mm_P0.65mm_ClockwisePinNumbering.step

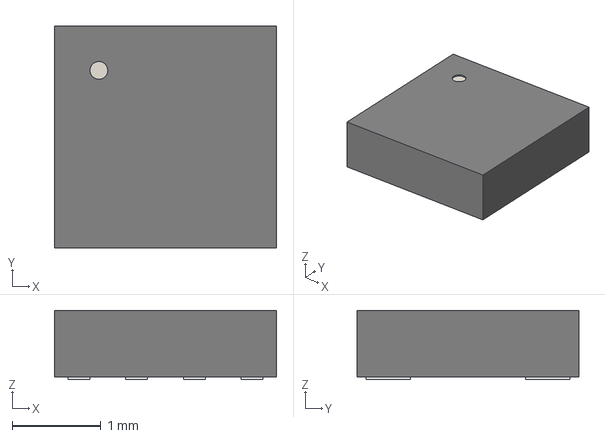
[picture p47: CAD file, 2026-08-27]
3D Models/Bosch_LGA-8_2.5x2.5mm_P0.65mm_ClockwisePinNumbering.step
2.50 x 2.50 x 0.78 mm
