TheMiz1os/WeatherStationV2/Project 3D Files and Models/weather-station-one-part-5/Anemometer.3mf

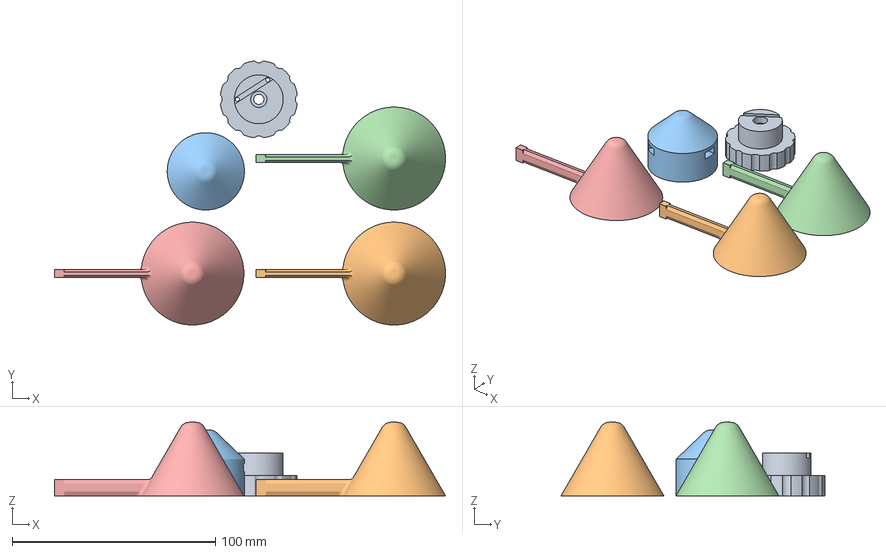
[picture p48: CAD file, 2026-01-24]
Project 3D Files and Models/weather-station-one-part-5/Anemometer.3mf
192.4 x 129.9 x 36.2 mm
AnemoReedMount.stl
AnemoFlyer.stl x 3
AnemoFlyersMount.stl
