TheMiz1os/WeatherStationV2/3D Models/SOT-223.step

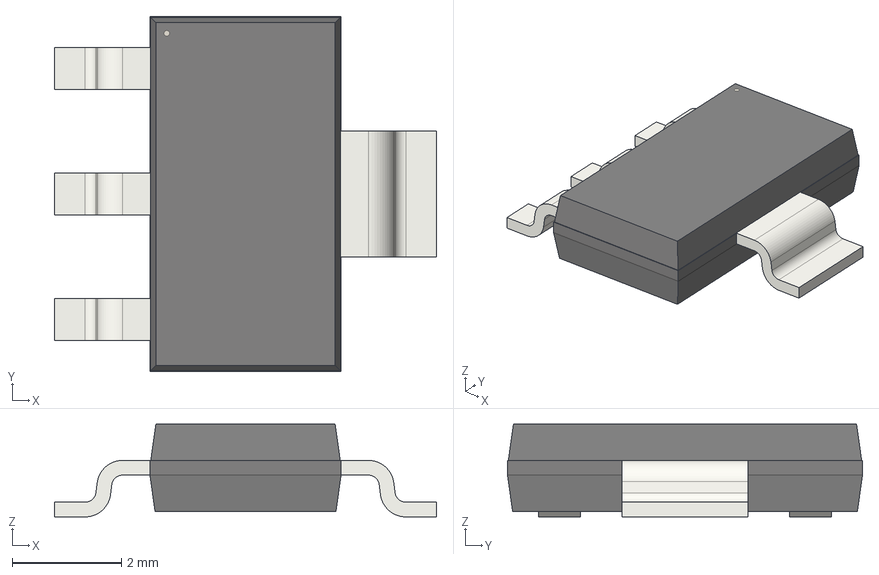
[picture p49: CAD file, 2026-08-27]
3D Models/SOT-223.step
7.00 x 6.50 x 1.70 mm
