TheMiz1os/WeatherStationV2/Project 3D Files and Models/weather-station-one-part-5/WindVaneSeal.stl

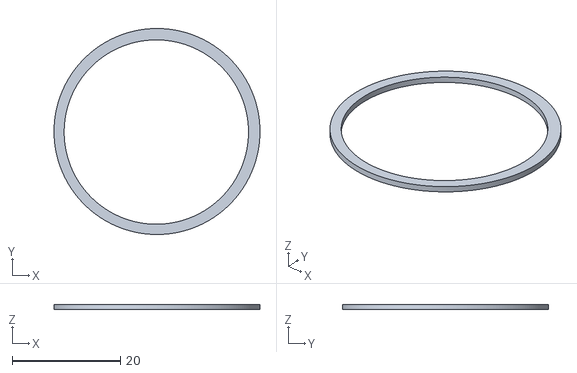
[picture p50: CAD file, 2026-01-24]
Project 3D Files and Models/weather-station-one-part-5/WindVaneSeal.stl
38.0 x 38.0 x 1.00
