TheMiz1os/WeatherStationV2/3D Models/D_SMA.step

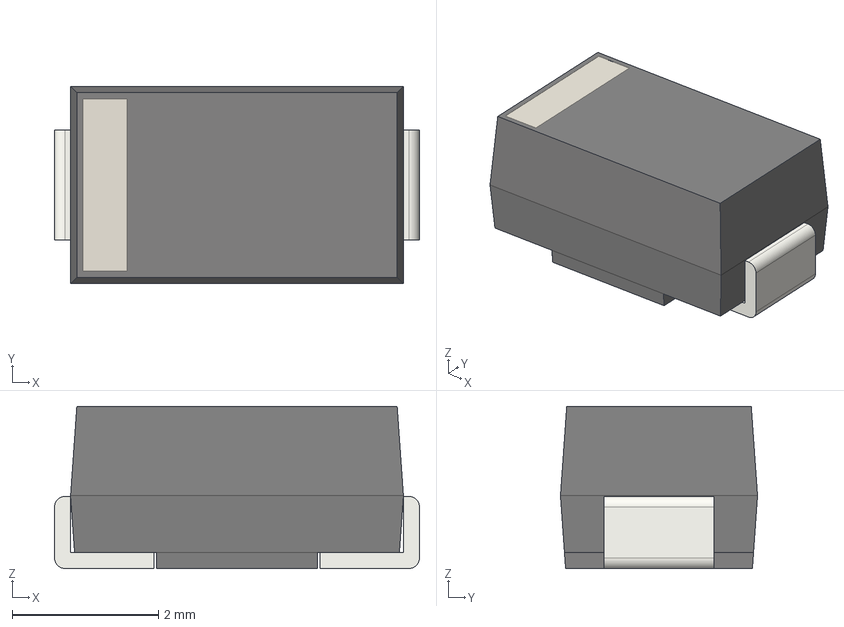
[picture p51: CAD file, 2026-08-27]
3D Models/D_SMA.step
5.00 x 2.70 x 2.22 mm
