TheMiz1os/WeatherStationV2/Project 3D Files and Models/weather-station-one-part-5/AnemoFlyer.stl

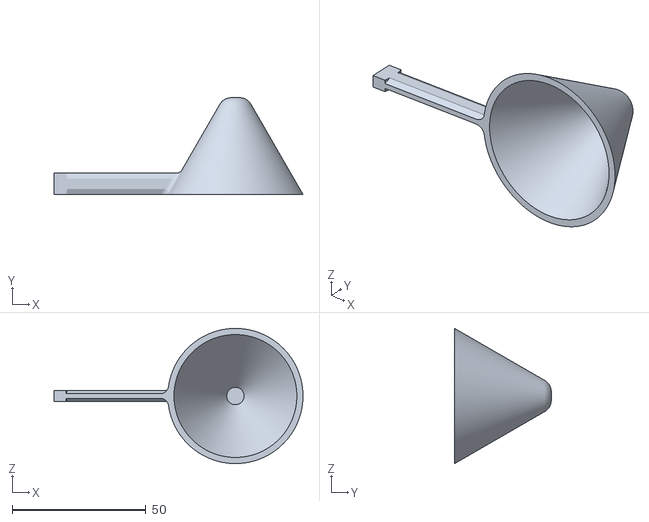
[picture p52: CAD file, 2026-01-24]
Project 3D Files and Models/weather-station-one-part-5/AnemoFlyer.stl
93.2 x 36.2 x 50.6
