TheMiz1os/WeatherStationV2/Project 3D Files and Models/weather-station-one-part-5/AnemoFlyersMount.stl

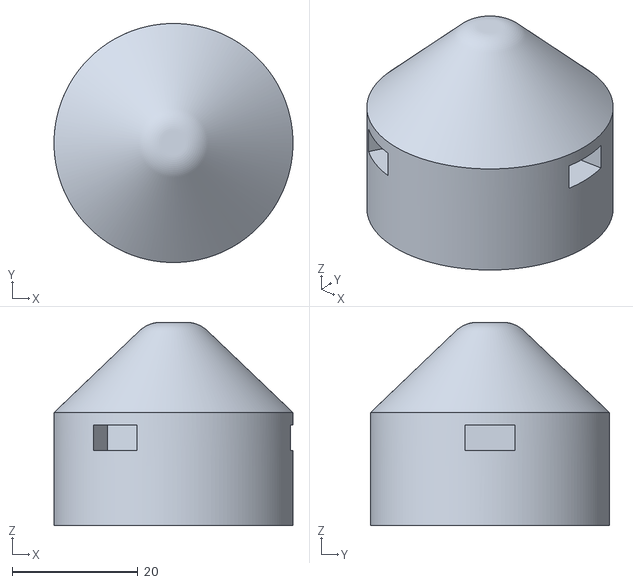
[picture p53: CAD file, 2026-01-24]
Project 3D Files and Models/weather-station-one-part-5/AnemoFlyersMount.stl
38.0 x 38.0 x 32.3
