TheMiz1os/WeatherStationV2/(list of files, cad)

Other CAD files:
Project 3D Files/adafruit-veml-7700-light-sensor-breakout-board-1.snapshot.2/Adafruit VEML 7700 Light Sensor Breakout Board.SLDPRT
Project 3D Files/cjmcu-680-bme680/CJMCU-680, BME680.STEP
Project 3D Files and Models/cjmcu-680-bme680/SMD Capacitor, Configurable, CJMCU-680, BME680 Ambient Temperature, Relative Humidity, Barometric Pressure, and Gas VOC Sensor.SLDPRT
3D Files/Main Assembly v17.3mf
Project 3D Files/OLD/Main Assembly v17.3mf
Project 3D Files/cjmcu-680-bme680/CJMCU-680, BME680 Ambient Temperature, Relative Humidity, Barometric Pressure, and Gas VOC Sensor.x_b
