TheMiz1os/WeatherStationV2/plots/Weather Station V2__Assembly.pdf

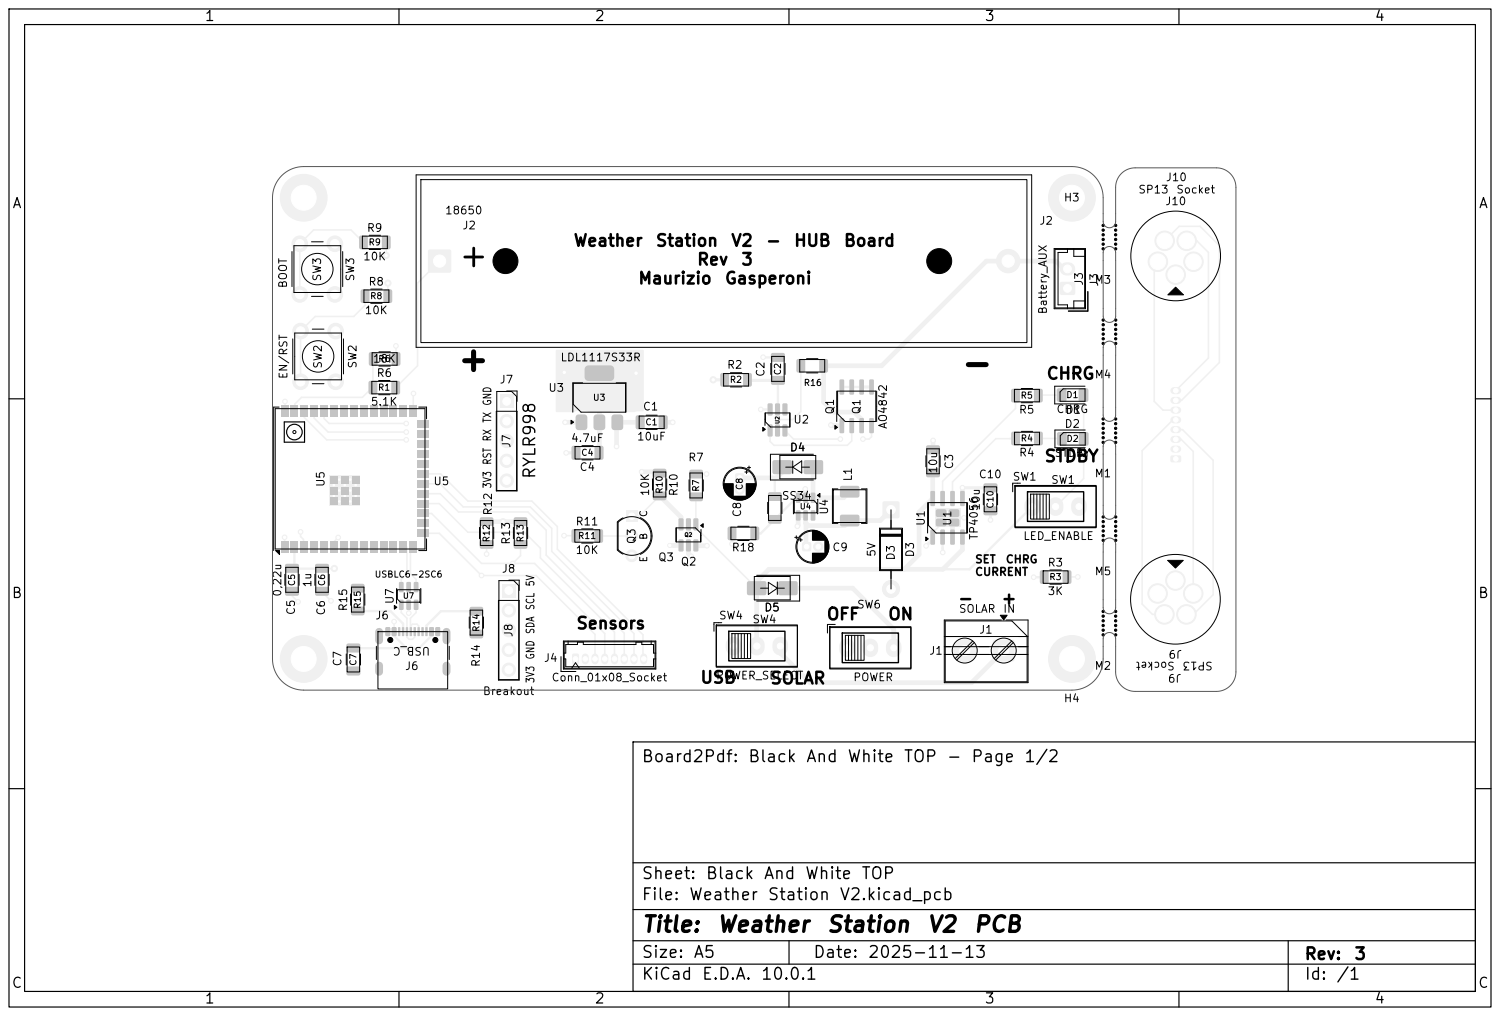
[picture p54: page 1]

Weather Station V2 - HUB Board

3V3 RST RX TX GND 3V3 GND SDA SCL 5V SET CHRG CURRENT RYLR998

Board2Pdf: Black And White TOP - Page 1/2

Sheet: Black And White TOP
File: Weather Station V2.kicad_pcb
Title: Weather Station V2 PCB
KiCad E.D.A. 10.0.1

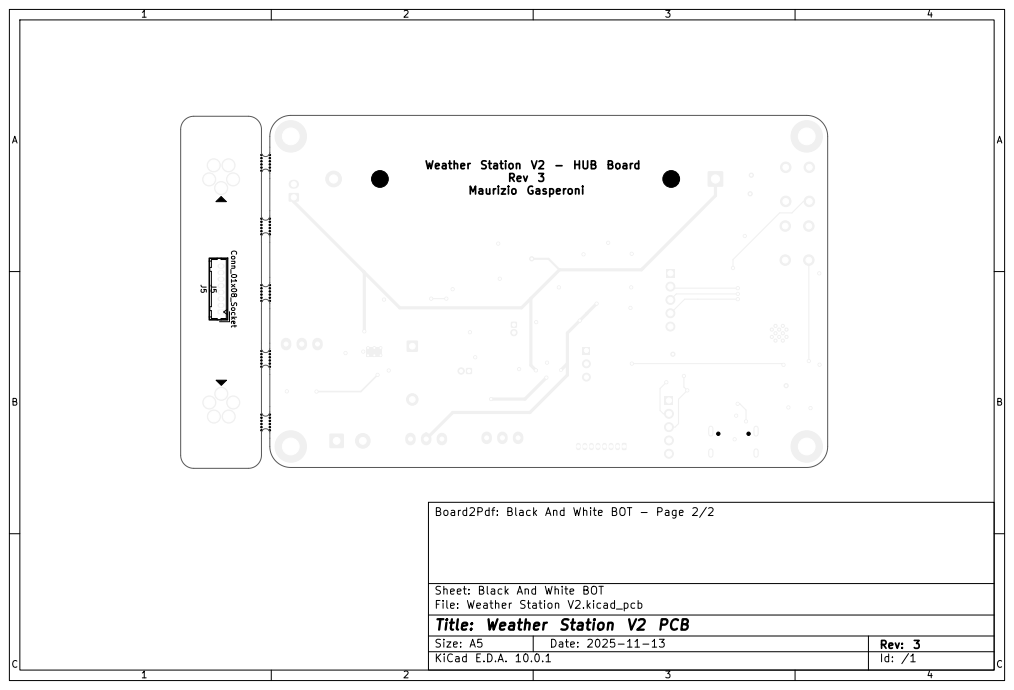
[picture p55: page 2]
Rev 3; Maurizio Gasperoni J5 1; C Date: 2025-11-13; Size: A5; Rev: 3

Weather Station V2 - HUB Board

Board2Pdf: Black And White BOT - Page 2/2 Conn_01x08_Socket J5

Sheet: Black And White BOT
File: Weather Station V2.kicad_pcb
Title: Weather Station V2 PCB
KiCad E.D.A. 10.0.1
