TheMiz1os/WeatherStationV2/Schematic PDF.pdf

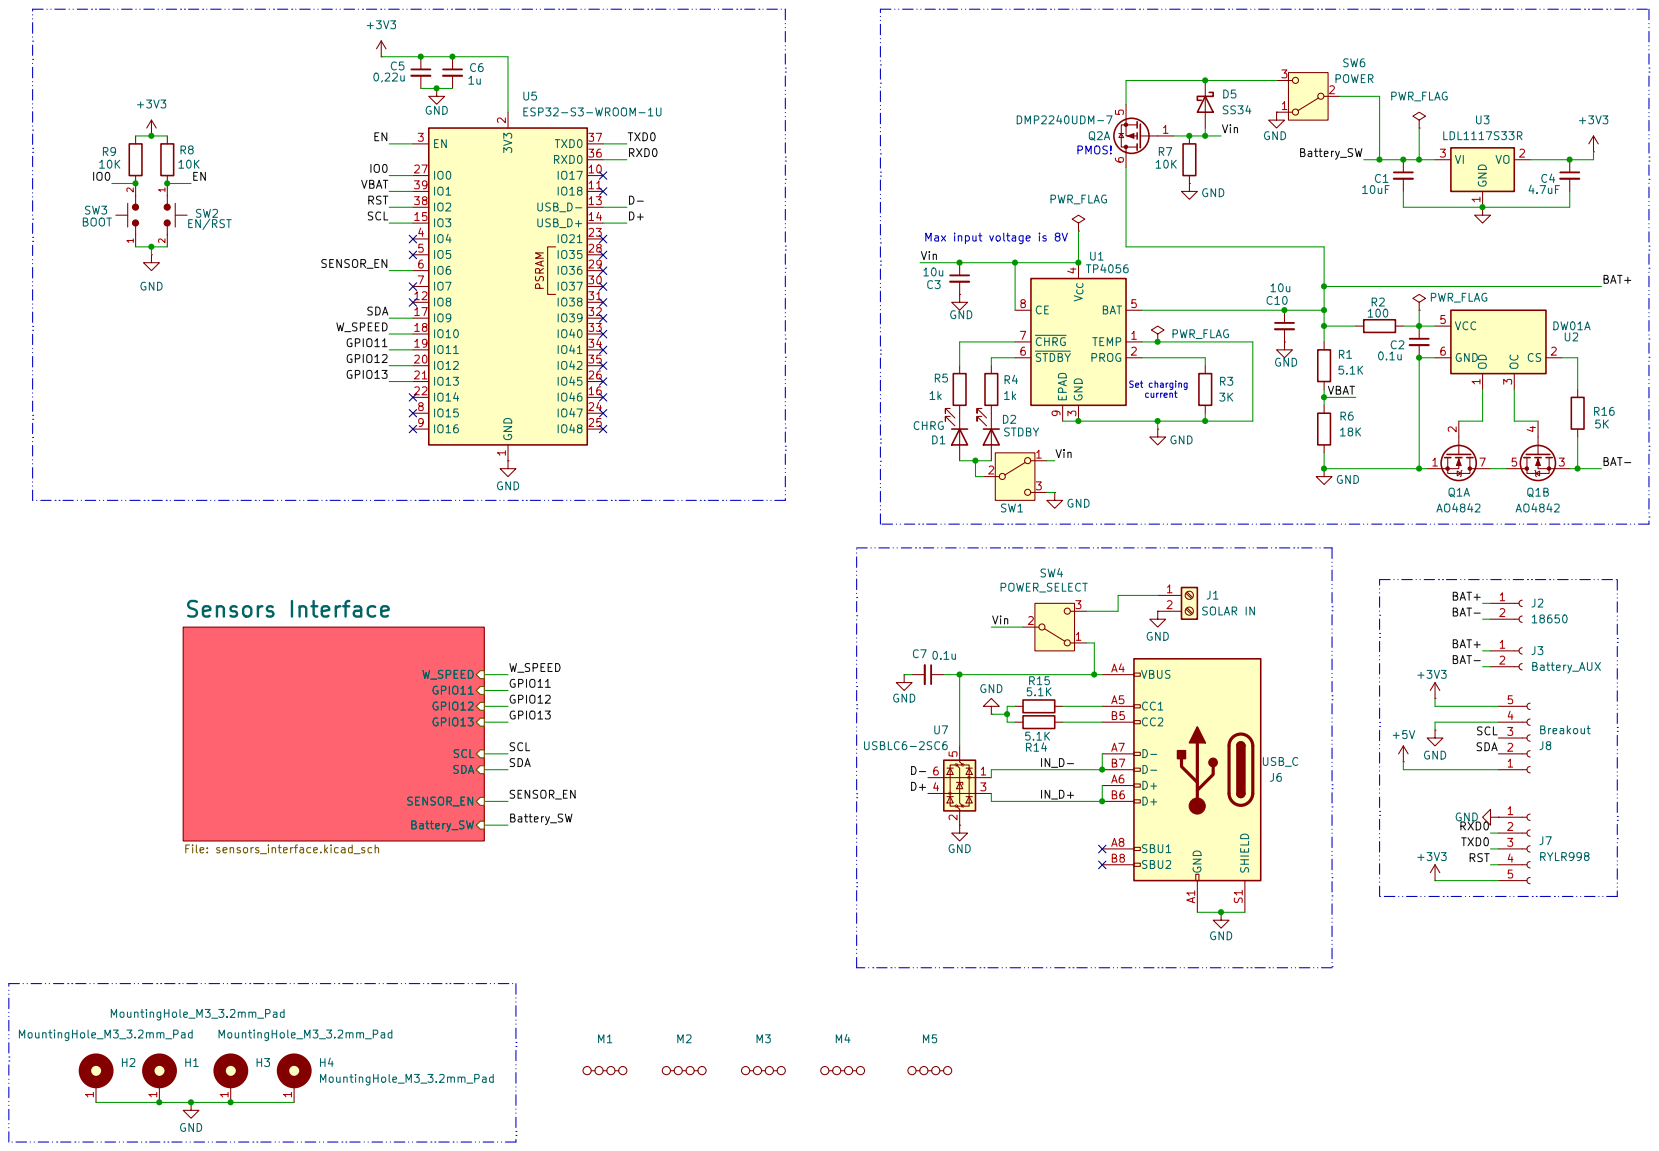
[picture p56: page 1]

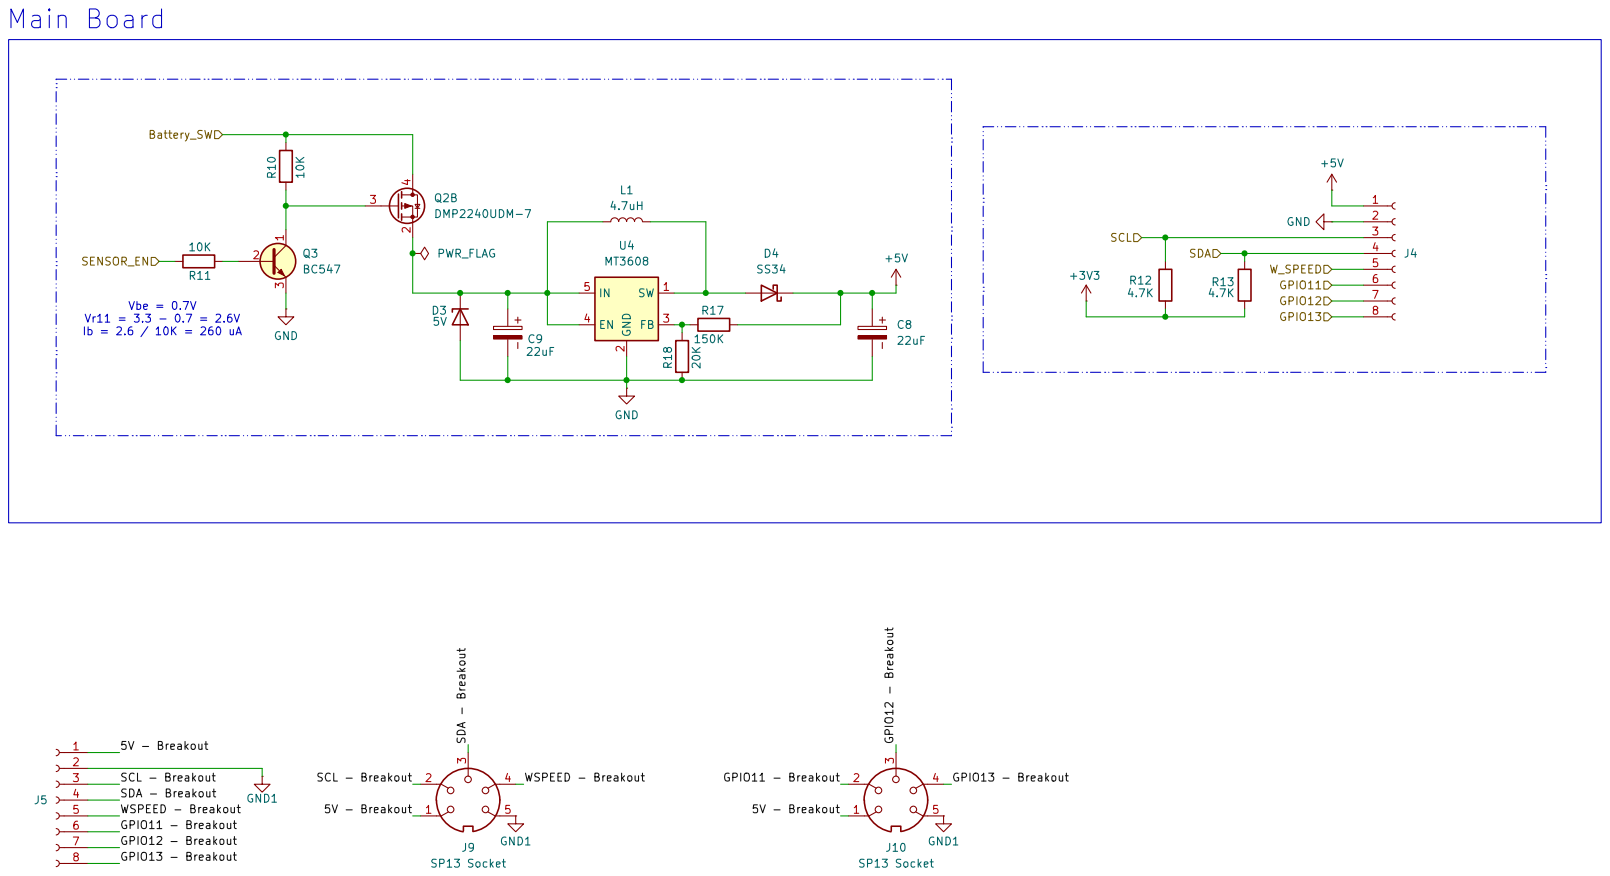
[picture p57: page 2]
