TheMiz1os/WeatherStationV2/Weather Station V2.kicad_pcb

## KiCad design Weather Station V2.kicad_pcb (2026-10-16)

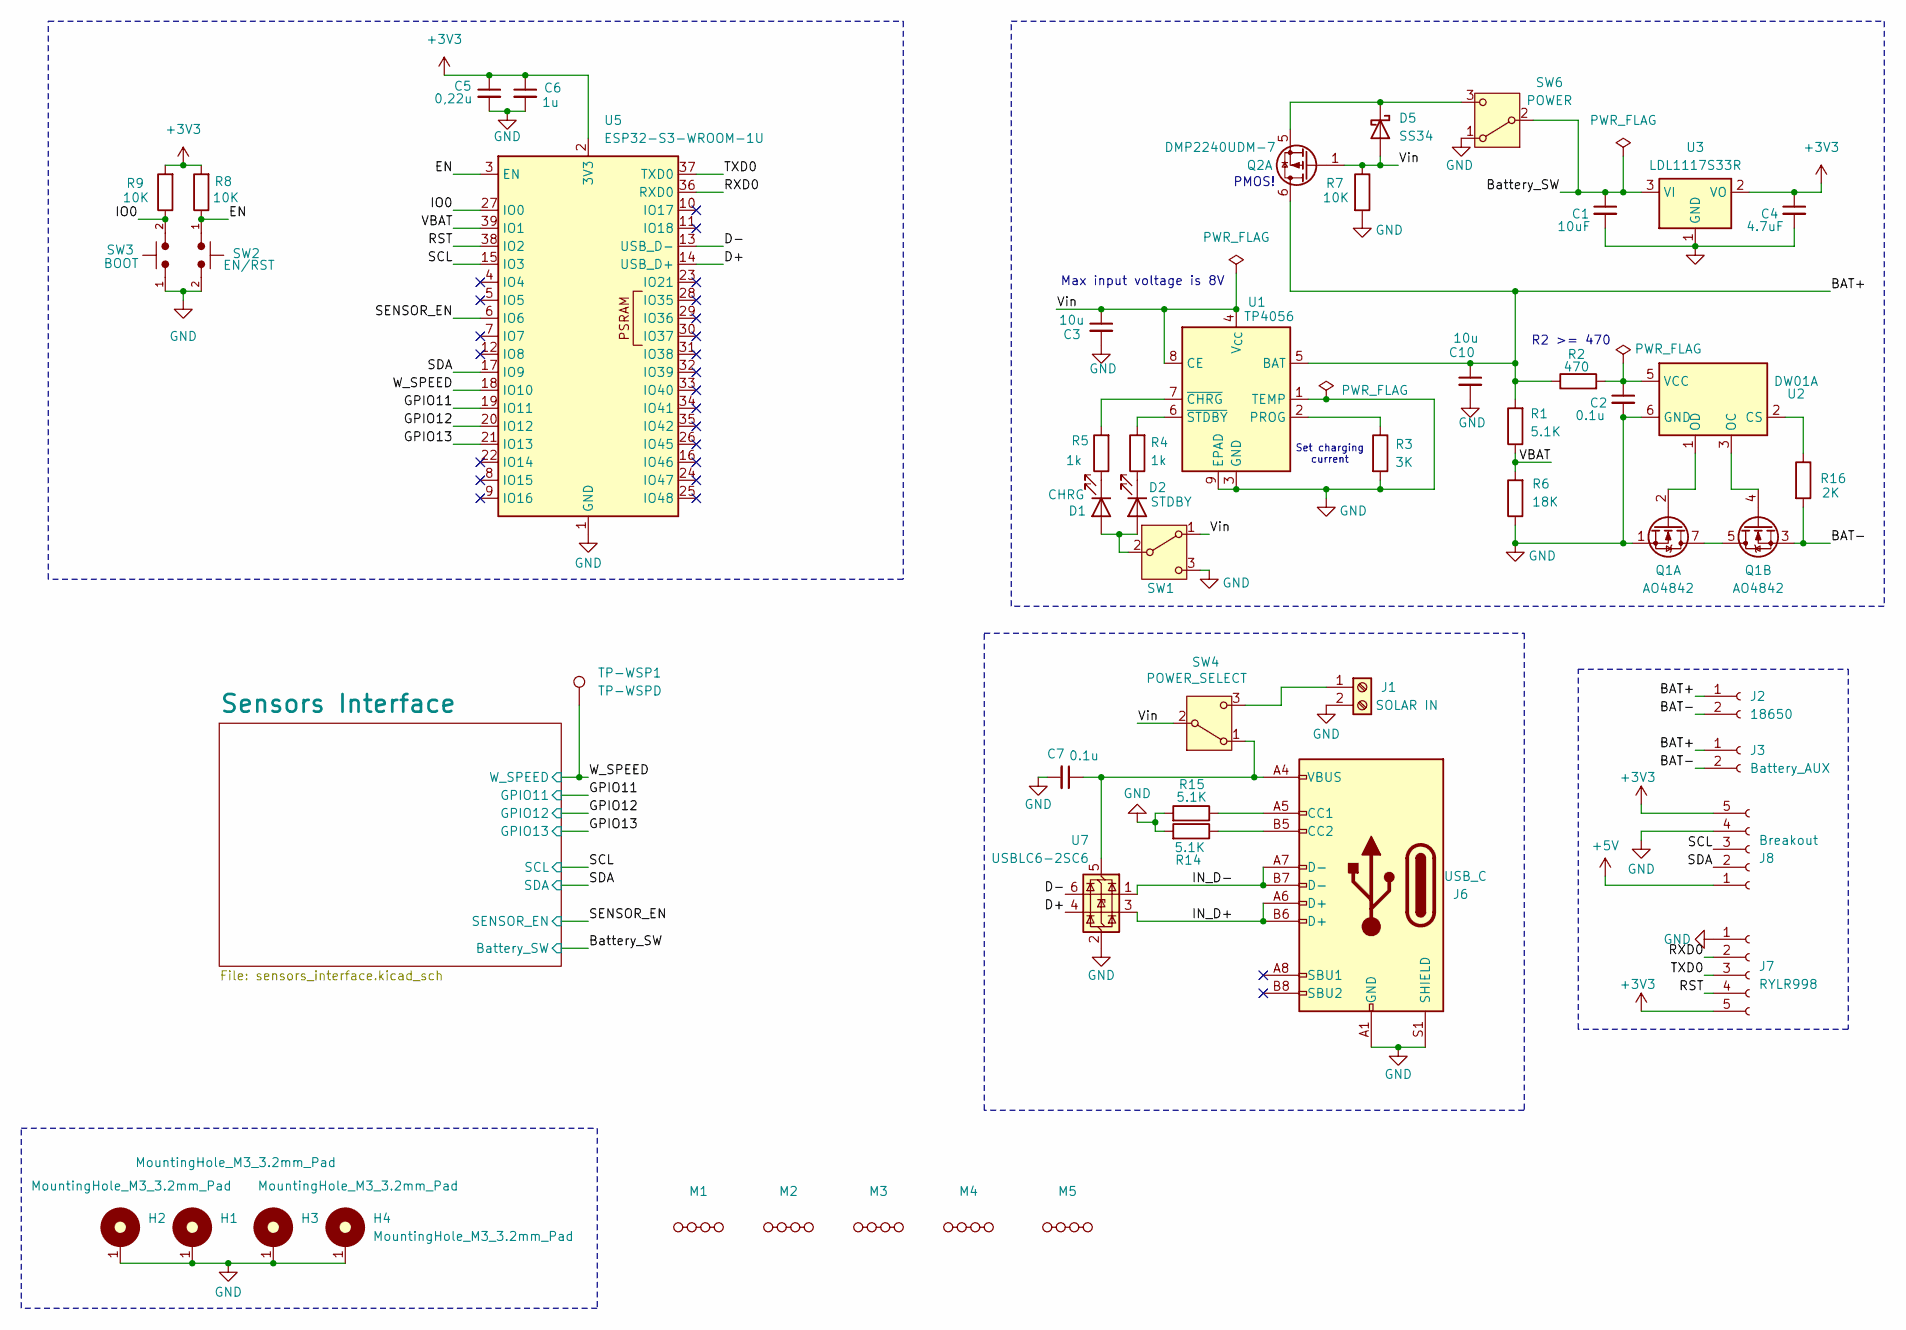
[picture p58: schematic Weather Station V2.kicad_sch]

Parts:
C1: 10uF; C_1206_3216Metric
C2, C7: 0.1u; C_1206_3216Metric
C3, C10: 10u; C_1206_3216Metric
C4: 4.7uF; C_1206_3216Metric
C5: 0,22u; C_1206_3216Metric
C6: 1u; C_1206_3216Metric
D1: CHRG; LED_1206_3216Metric
D2: STDBY; LED_1206_3216Metric
D5: SS34; D_SMA
H1, H2, H3, H4: MountingHole_M3_3.2mm_Pad; MountingHole_3.2mm_Pad
J1: SOLAR IN; TerminalBlock_MaiXu_MX126-5.0-02P_1x02_P5.00mm
J2: 18650; BatteryHolder_MPD_BH-18650-PC
J3: Battery_AUX; JST_EH_B2B-EH-A_1x02_P2.50mm_Vertical
J6: USB_C; USB_C_Receptacle_GCT_USB4105-xx-A_16P_TopMnt_Horizontal
J7: RYLR998; PinSocket_1x05_P2.54mm_Vertical
J8: Breakout; PinSocket_1x05_P2.54mm_Vertical
M1, M2, M3, M4, M5: MouseBites, Cosmetic, JLCPCB, 1.6mm
Q1: AO4842; SOIC-8_3.9x4.9mm_P1.27mm
Q2: DMP2240UDM-7; SOT-23-6_Handsoldering
R1, R14, R15: 5.1K; R_1206_3216Metric
R2: 470; R_1206_3216Metric
R3: 3K; R_1206_3216Metric
R4, R5: 1k; R_1206_3216Metric
R6: 18K; R_1206_3216Metric
R7, R8, R9: 10K; R_1206_3216Metric
R16: 2K; R_1206_3216Metric
SW1: LED_ENABLE; Slide_Switch_SPDT_P3mm_10x5x10mm
SW2: EN/RST; SW_PUSH_6mm
SW3: BOOT; SW_PUSH_6mm
SW4: POWER_SELECT; Slide_Switch_SPDT_P3mm_10x5x10mm
SW6: POWER; Slide_Switch_SPDT_P3mm_10x5x10mm
TP-WSP1: TP-WSPD; TestPoint_THTPad_D2.0mm_Drill1.0mm
U1: TP4056; SOIC-8-1EP_3.9x4.9mm_P1.27mm_EP2.41x3.3mm_ThermalVias
U2: DW01A; SOT-23-6_Handsoldering
U3: LDL1117S33R; SOT-223-3_TabPin2
U5: ESP32-S3-WROOM-1U
U7: USBLC6-2SC6; SOT-23-6

Connections:
+3V3: C4.1, C5.1, C6.1, J7.5, J8.5, R8.2, R9.2, U3.2 (VO), U5.2 (3V3); also elsewhere on the board
+5V: J8.1; also elsewhere on the board
/BAT+: C10.1, J2.1, J3.1, Q2.6 (D), R1.2, R2.1, U1.5 (BAT)
/BAT-: J2.2, J3.2, Q1.3 (S2), R16.2
/Battery_SW: C1.1, SW6.2 (B), U3.3 (VI); also elsewhere on the board
/D+: U5.14 (USB_D+), U7.4 (I/O2)
/D-: U5.13 (USB_D-), U7.6 (I/O1)
/EN: R8.1, SW2.1, U5.3 (EN)
/GPIO11: U5.19 (IO11); also elsewhere on the board
/GPIO12: U5.20 (IO12); also elsewhere on the board
/GPIO13: U5.21 (IO13); also elsewhere on the board
/IN_D+: J6.A6 (D+), J6.B6 (D+), U7.3 (I/O2)
/IN_D-: J6.A7 (D-), J6.B7 (D-), U7.1 (I/O1)
/IO0: R9.1, SW3.2, U5.27 (IO0)
/RST: J7.4, U5.38 (IO2)
/RXD0: J7.2, U5.36 (RXD0)
/SCL: J8.3, U5.15 (IO3); also elsewhere on the board
/SDA: J8.2, U5.17 (IO9); also elsewhere on the board
/SENSOR_EN: U5.6 (IO6); also elsewhere on the board
/TXD0: J7.3, U5.37 (TXD0)
/VBAT: R1.1, R6.2, U5.39 (IO1)
/Vin: C3.1, D5.2 (A), Q2.1 (G), R7.1, SW1.1 (A), SW4.2 (B), U1.4 (V_{CC}), U1.8 (CE)
/W_SPEED: TP-WSP1.1, U5.18 (IO10); also elsewhere on the board
GND: C1.2, C2.2, C3.2, C4.2, C5.2, C6.2, C7.2, C10.2, H1.1, H2.1, H3.1, H4.1, J1.2, J6.A1 (GND), J6.A12 (GND), J6.B1 (GND), J6.B12 (GND), J6.S1 (SHIELD), J7.1, J8.4, Q1.1 (S1), R3.2, R6.1, R7.2, R14.2, R15.2, SW1.3 (C), SW2.2, SW3.1, SW6.1 (A), U1.1 (TEMP), U1.3 (GND), U1.9 (EPAD), U2.6 (GND), U3.1 (GND), U5.1 (GND), U5.40 (GND), U5.41 (GND), U7.2 (GND); also elsewhere on the board
unnamed: D1.2 (A), D2.2 (A), SW1.2 (B)
unnamed: D1.1 (K), R5.1
unnamed: D2.1 (K), R4.1
unnamed: D5.1 (K), Q2.5 (S), SW6.3 (C)
unnamed: J1.1, SW4.3 (C)
unnamed: J6.A5 (CC1), R15.1
unnamed: J6.B5 (CC2), R14.1
unnamed: Q1.5 (D2), Q1.6 (D2), Q1.7 (D1), Q1.8 (D1)
unnamed: Q1.2 (G1), U2.1 (OD)
unnamed: Q1.4 (G2), U2.3 (OC)
unnamed: C7.1, J6.A4 (VBUS), J6.A9 (VBUS), J6.B4 (VBUS), J6.B9 (VBUS), SW4.1 (A), U7.5 (VBUS)
unnamed: R3.1, U1.2 (PROG)
unnamed: R5.2, U1.7 (~CHRG)
unnamed: R4.2, U1.6 (~STDBY)
unnamed: R16.1, U2.2 (CS)
unnamed: C2.1, R2.2, U2.5 (VCC)

Notes on the sheet:
R2 >= 470
PMOS!
Set charging current
Max input voltage is 8V

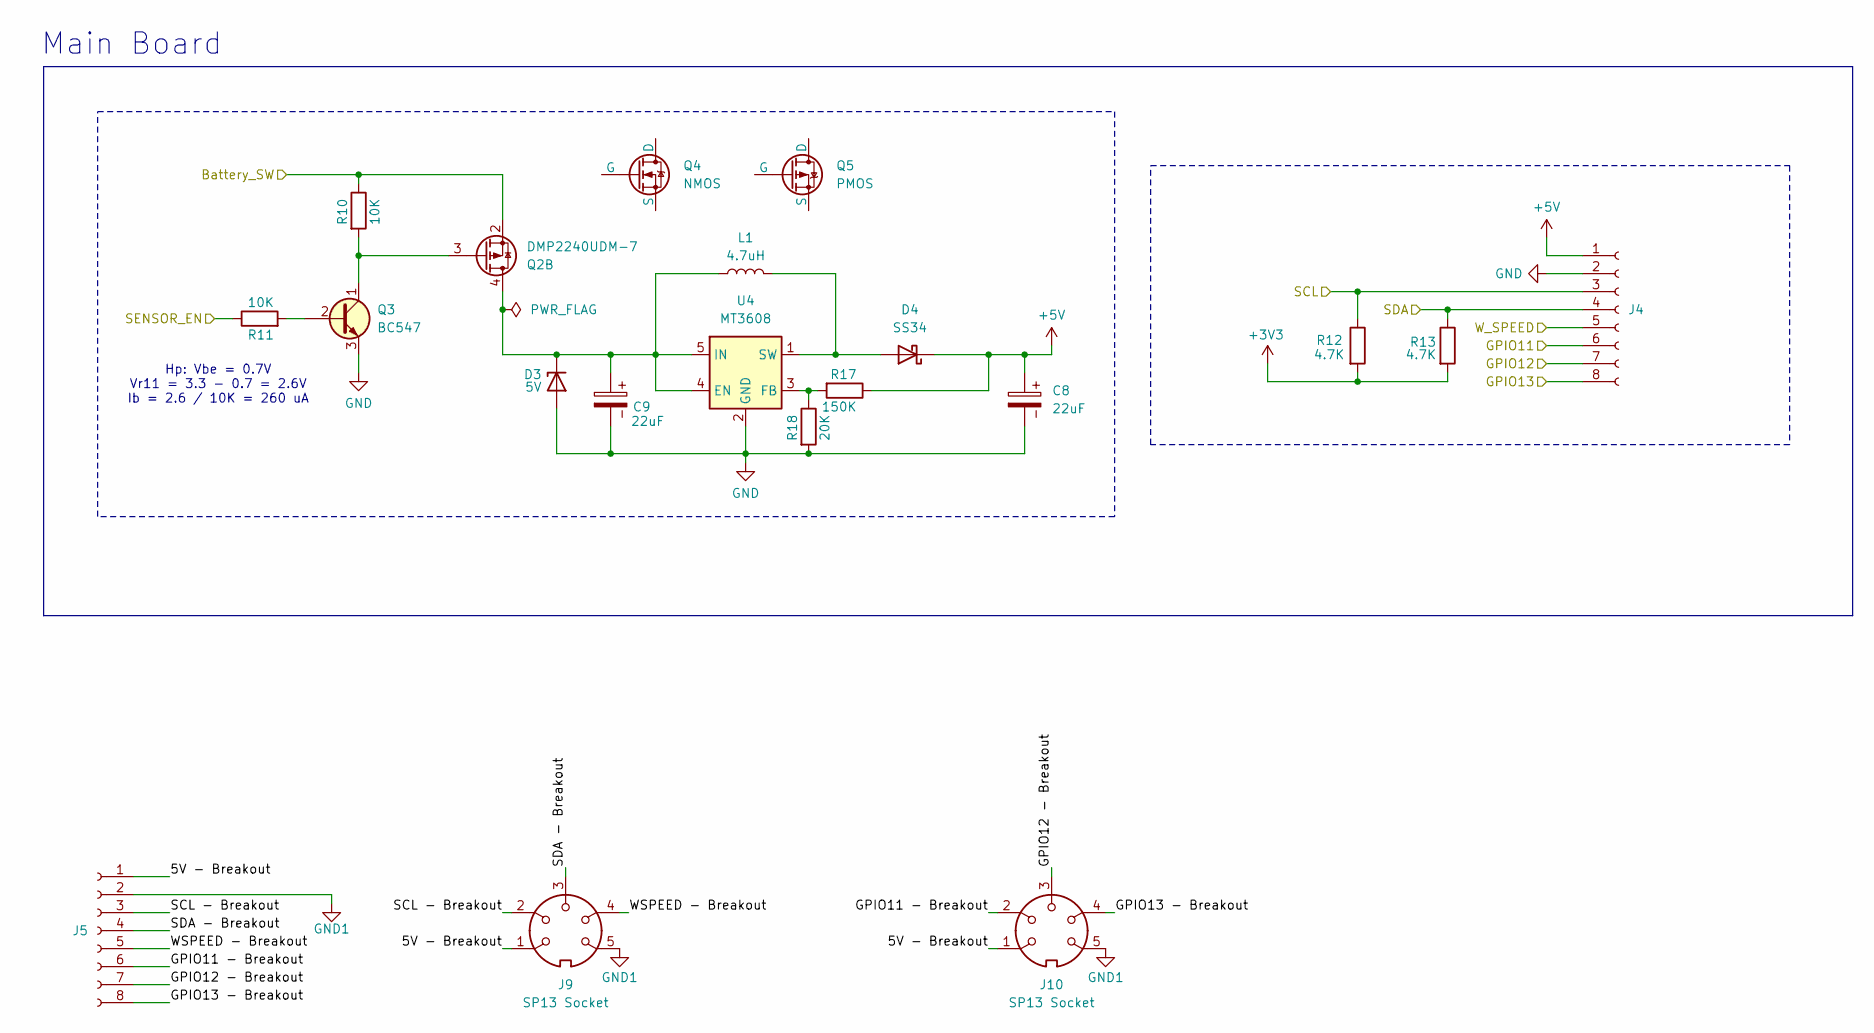
[picture p59: schematic sensors_interface.kicad_sch]

Parts:
C8, C9: 22uF; CP_Radial_D4.0mm_P1.50mm
D3: 5V; D_DO-41_SOD81_P10.16mm_Horizontal
D4: SS34; D_SMA
J4, J5: Conn_01x08_Socket; Hirose_DF13-08P-1.25DSA_1x08_P1.25mm_Vertical
J9, J10: SP13 Socket; SP13_5pin_holes
L1: 4.7uH; L_APV_APH0420
Q2: DMP2240UDM-7; SOT-23-6_Handsoldering
Q3: BC547; TO-92_Inline_Wide_CBE
Q4: NMOS
Q5: PMOS
R10, R11: 10K; R_1206_3216Metric
R12, R13: 4.7K; R_1206_3216Metric
R17: 150K; R_1206_3216Metric
R18: 20K; R_1206_3216Metric
U4: MT3608; SOT-23-6

Connections:
+3V3: R12.2, R13.2; also elsewhere on the board
+5V: C8.1, D4.1 (K), J4.1, R17.1; also elsewhere on the board
/Battery_SW: Q2.2 (S), R10.1; also elsewhere on the board
/GPIO11: J4.6; also elsewhere on the board
/GPIO12: J4.7; also elsewhere on the board
/GPIO13: J4.8; also elsewhere on the board
/SCL: J4.3, R12.1; also elsewhere on the board
/SDA: J4.4, R13.1; also elsewhere on the board
/SENSOR_EN: R11.1; also elsewhere on the board
/Sensors Interface/5V - Breakout: J5.1, J9.1, J10.1
/Sensors Interface/GPIO11 - Breakout: J5.6, J10.2
/Sensors Interface/GPIO12 - Breakout: J5.7, J10.3
/Sensors Interface/GPIO13 - Breakout: J5.8, J10.4
/Sensors Interface/SCL - Breakout: J5.3, J9.2
/Sensors Interface/SDA - Breakout: J5.4, J9.3
/Sensors Interface/WSPEED - Breakout: J5.5, J9.4
/W_SPEED: J4.5; also elsewhere on the board
GND: C8.2, C9.2, D3.2 (A), J4.2, Q3.3 (E), R18.2, U4.2 (GND); also elsewhere on the board
GND1: J5.2, J9.5, J10.5
unnamed: C9.1, D3.1 (K), L1.1, Q2.4 (D), U4.4 (EN), U4.5 (IN)
unnamed: D4.2 (A), L1.2, U4.1 (SW)
unnamed: Q2.3 (G), Q3.1 (C), R10.2
unnamed: Q3.2 (B), R11.2
unnamed: R17.2, R18.1, U4.3 (FB)

Notes on the sheet:
Main Board
Hp: Vbe = 0.7V Vr11 = 3.3 - 0.7 = 2.6V Ib = 2.6 / 10K = 260 uA

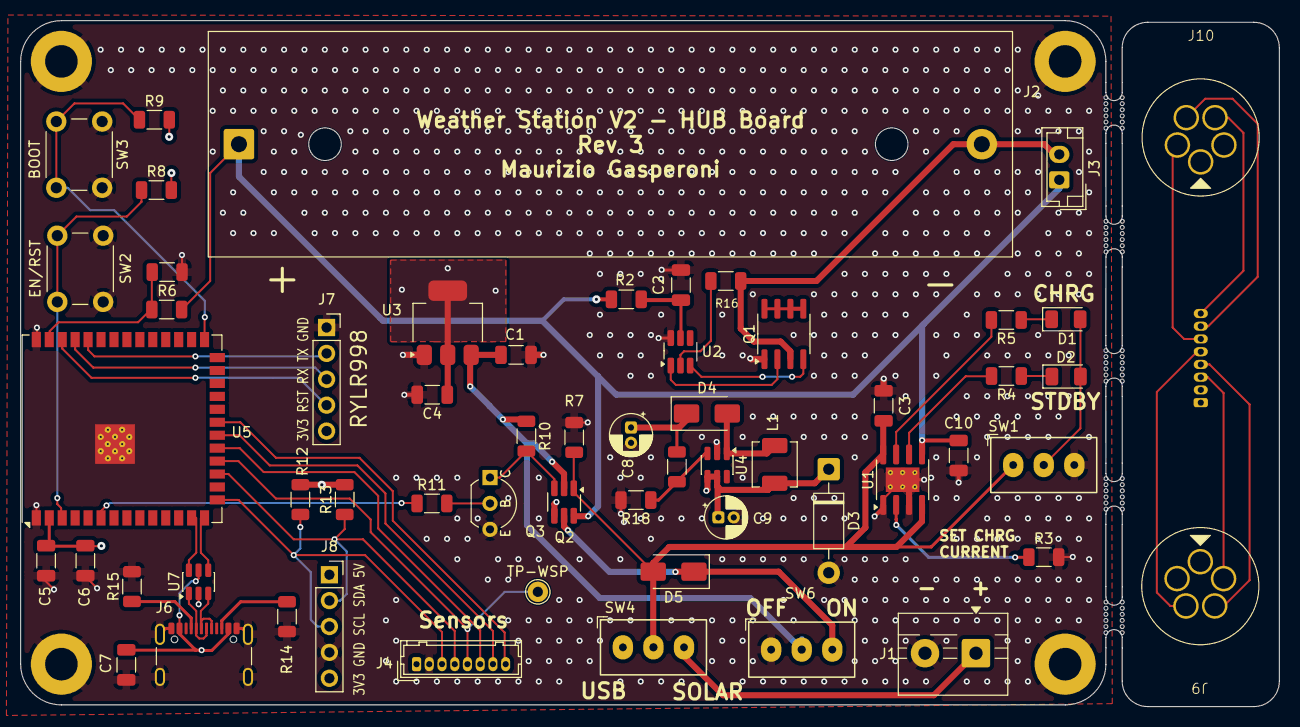
[picture p60: board Weather Station V2.kicad_pcb from above]

Board: 4 copper layers, 123.5 x 67.3 mm, 68 parts (1 on the bottom side), 53 nets.

Other parts of the board:
TP-WSP: TP-WSPD; TestPoint_THTPad_D2.0mm_Drill1.0mm

Their connections:
/W_SPEED: TP-WSP.1 (1_1); also elsewhere on the board
