TheMiz1os/WeatherStationV2/_Secondary board/Secondary Board.kicad_pcb

## KiCad design _Secondary board/Secondary Board.kicad_pcb (2026-10-01)

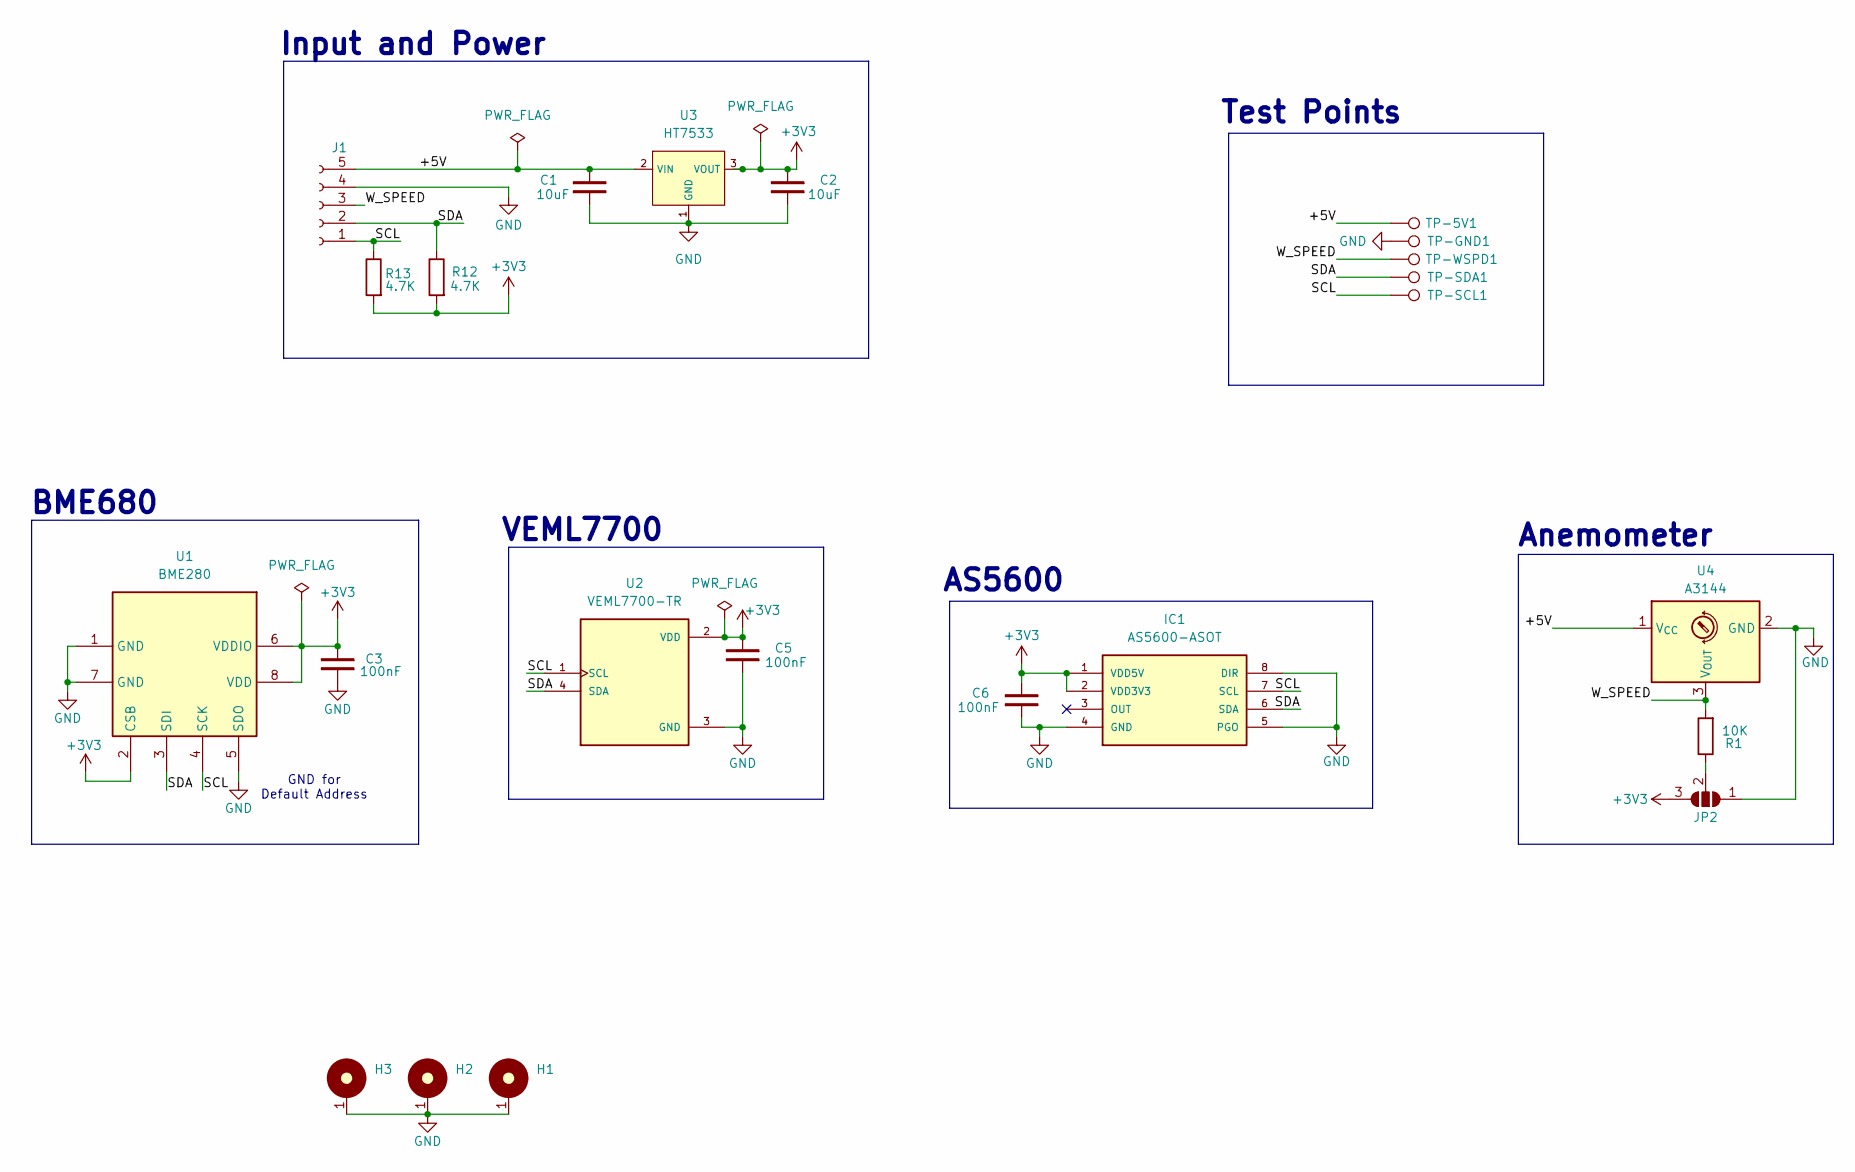
[picture p61: schematic Secondary Board.kicad_sch]

Parts:
C1, C2: 10uF; C_1206_3216Metric_Pad1.33x1.80mm_HandSolder
C3, C5, C6: 100nF; C_1206_3216Metric_Pad1.33x1.80mm_HandSolder
H1, H2, H3: MountingHole_M3_3.2mm_Pad; MountingHole_3.2mm_M3_ISO7380_Pad
IC1: AS5600-ASOT; SOIC127P600X175-8N; MOUSER_PART_NUMBER 985-AS5600-ASOT
J1: Conn_01x05_Socket; Hirose_DF13-05P-1.25DSA_1x05_P1.25mm_Vertical
JP2: SolderJumper_3_Open; SolderJumper-3_P1.3mm_Open_RoundedPad1.0x1.5mm
R1: 10K; R_1206_3216Metric
R12, R13: 4.7K; R_1206_3216Metric
TP-5V1: TestPoint; TestPoint_THTPad_D1.5mm_Drill0.7mm
TP-GND1: TestPoint; TestPoint_THTPad_D1.5mm_Drill0.7mm
TP-SCL1: TestPoint; TestPoint_THTPad_D1.5mm_Drill0.7mm
TP-SDA1: TestPoint; TestPoint_THTPad_D1.5mm_Drill0.7mm
TP-WSPD1: TestPoint; TestPoint_THTPad_D1.5mm_Drill0.7mm
U1: BME280; Bosch_LGA-8_2.5x2.5mm_P0.65mm_ClockwisePinNumbering
U2: VEML7700-TR; XDCR_VEML7700-TR; PARTREV 1.6; DigiKey_Part_Number VEML7700CT-ND
U3: HT7533; SOT-89-3_L4.5-W2.5-P1.50-LS4.2-BR; Output Voltage 3.3V; Dropout Voltage 55mV@(1mA); Part HT7533-1; LCSC C14289
U4: A3144; TO-92S

Connections:
+3V3: C2.2, C3.2, C5.2, C6.2, IC1.1 (VDD5V), IC1.2 (VDD3V3), JP2.3 (B), R12.2, R13.2, U1.2 (CSB), U1.6 (VDDIO), U1.8 (VDD), U2.2 (VDD), U3.3 (VOUT)
/+5V: C1.2, J1.5, TP-5V1.1 (1_1), U3.2 (VIN), U4.1 (V_{CC})
/SCL: IC1.7 (SCL), J1.1, R13.1, TP-SCL1.1 (1_1), U1.4 (SCK), U2.1 (SCL)
/SDA: IC1.6 (SDA), J1.2, R12.1, TP-SDA1.1 (1_1), U1.3 (SDI), U2.4 (SDA)
/W_SPEED: J1.3, R1.2, TP-WSPD1.1 (1_1), U4.3 (V_{OUT})
GND: C1.1, C2.1, C3.1, C5.1, C6.1, H1.1, H2.1, H3.1, IC1.4 (GND), IC1.5 (PGO), IC1.8 (DIR), J1.4, JP2.1 (A), TP-GND1.1 (1_1), U1.1 (GND), U1.5 (SDO), U1.7 (GND), U2.3 (GND), U3.1 (GND), U4.2 (GND)
unnamed: JP2.2 (C), R1.1

Notes on the sheet:
Anemometer
AS5600
VEML7700
Input and Power
GND for Default Address
BME680
Test Points

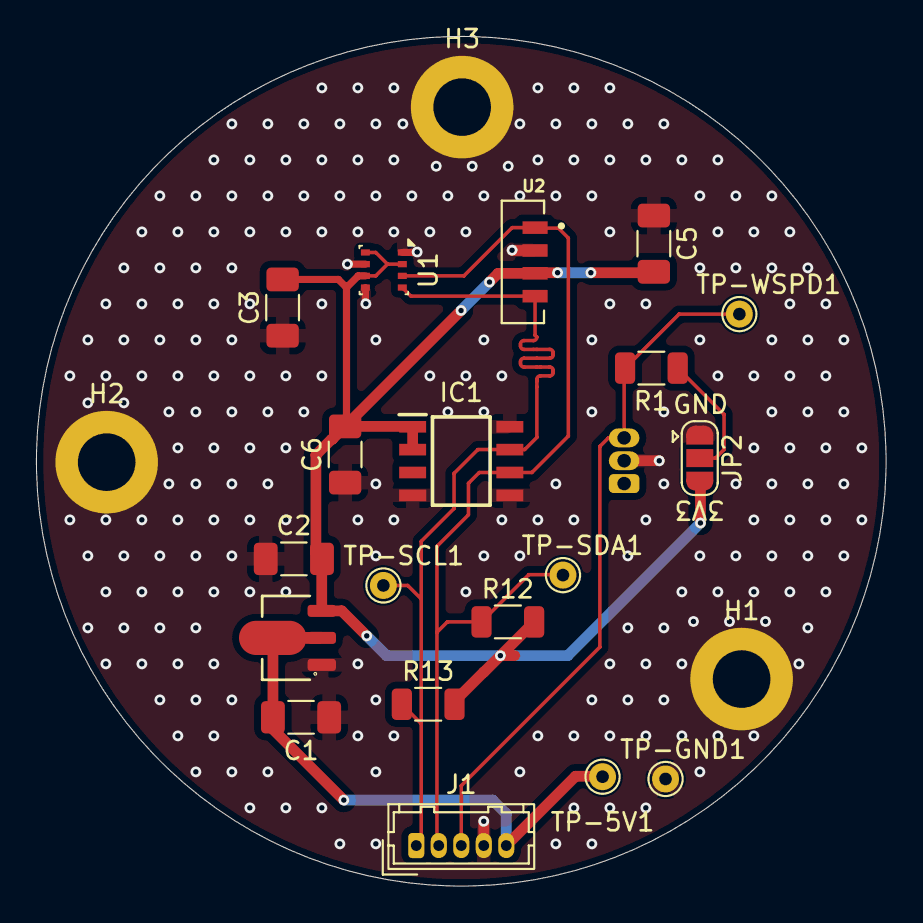
[picture p62: board Secondary Board.kicad_pcb from above]

Board: 2 copper layers, 47.2 x 47.2 mm, 23 parts (1 on the bottom side), 7 nets.
