TheMiz1os/WeatherStationV2/(commit log)

2026-01-24 Initial Commit Full configuration with RJ45 Connector
    [3.3V LDO Regulator, CJMCU-680, BME680 Ambient Temperature, Relative Humidity, Barometric Pressure, and Gas VOC Sensor.SLDPRT, 8 Legs SMD Component, CJMCU-680, BME680 Ambient Temperature, Relative Humidity, Barometric Pressure, and Gas VOC Sensor.SLDPRT, AS5600.step, Adafruit VEML 7700 Light Sensor Breakout Board.SLDPRT, Adafruit VEML 7700 Light Sensor Breakout Board.STEP, AnemoFlyer.stl, AnemoFly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]
2026-01-24 Replaced RJ45 with 1x8 P1.25mm JST connector Fix: line ends normalization for kicad files
    [Adafruit VEML 7700 Light Sensor Breakout Board.STEP, Weather Station V2.kicad_pcb, sensors_interface.kicad_sch]
2026-01-24 Started the breakout board schematic
    [Sensor Board.kicad_sch, sensors_interface.kicad_sch]
2026-02-06 Secondary Board now has the hall sensor interated Fixed BME680 schematic mistakes Updated gitignore
    [Secondary Board.kicad_pcb, Secondary Board.kicad_sch]
2026-02-06 Properly saved the files
    [Secondary Board.kicad_sch]
2026-02-07 Replaced BME680 with BME280 Added Testpoints
    [Secondary Board.kicad_pcb, Secondary Board.kicad_sch, Secondary Board.step]
2026-02-12 Added breakoout board - no panelization done yet Manufacturing capabilities have not been checked
    [Weather Station V2.kicad_pcb, sensors_interface.kicad_sch]
2026-02-12 Added esp32 connection to charging status lines (CHRG 48, STDBY 47) Panelization with breakout board. Potentially final. Proably sending it soon
    [Weather Station V2.kicad_pcb, Weather Station V2.kicad_sch, bom.csv, designators.csv, positions.csv]
2026-02-12 Updated Production Files
    [bom.csv, designators.csv, positions.csv]
2026-02-16 Now sensor power gets switched before 5V boost-coverter Reduced 3.3v plane size
    [Secondary Board.kicad_pcb, Secondary Board.step, Weather Station V2.kicad_pcb, Weather Station V2.kicad_sch, positions.csv, sensors_interface.kicad_sch]
2026-04-09 Updated to KiCAD 10.0 Final Commit before JCLPCB Order
    [Main Assembly v17.3mf, Main Assembly v28.3mf, Secondary Board.kicad_pcb, Secondary Board.kicad_sch, Sensor Hub.3mf, Weather Station V2.kicad_pcb, bom.csv, designators.csv]
2026-06-26 - Changed CHRG and STDBY pins to 48 and 47 (CHRG was strapping) - Exposed 5V rail do Breakout connector. Now also it matches a bme280 pinout for testing - Renamed BatteryReg net to Battery_SW - Fixed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
    [Secondary Board.kicad_pcb, Sensor Hub.3mf, Weather Station V2.kicad_pcb, Weather Station V2.kicad_sch, sensors_interface.kicad_sch]
2026-06-26 - Changed 3V3 LDO to LDL1117S33R - In a previous commit ON OFF power lables were switched
    [Weather Station V2.kicad_pcb, Weather Station V2.kicad_sch]
2026-07-04 - Chnaged to USBLC6-2SC6 for USB ESD protection - Expose 5V rail to Breakout - Fixed missing battery track to power sensors;
    - TO DO: open collector mosfet driver to 5V reg
    [Weather Station V2.kicad_pcb, Weather Station V2.kicad_sch, sensors_interface.kicad_sch]
2026-07-09 - Connected open collector mosfet driver to 5V reg - Re-routed tracks related to NMOS
    [Weather Station V2.kicad_pcb, Weather Station V2.kicad_sch, bom.csv, designators.csv, positions.csv, sensors_interface.kicad_sch]
2026-07-16 - Fixed Back to Back mosfet (now the follow DW01A datasheet) - Connected STDBY and CHRG leds to Vin - Removed STDBY and CHRG mcu monitoring (risk of frying the pins) - TP4056 Vcc cap 0.1 to 10 uf - A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
    [Weather Station V2.kicad_pcb, Weather Station V2.kicad_sch]
2026-07-26 - Changed revision to Rev 3 - Removed Production Folder - Changed DW01A Resistor value to match datasheet
    [Weather Station V2.kicad_pcb, Weather Station V2.kicad_sch, bom.csv, designators.csv, positions.csv]
2026-08-27 - Updated BOM
2026-08-27 - Localized Libraries
    [Bosch_LGA-8_2.5x2.5mm_P0.65mm_ClockwisePinNumbering.step, CP_Radial_D4.0mm_P1.50mm.step, C_1206_3216Metric.step, C_Disc_D3.0mm_W2.0mm_P2.50mm.step, D_DO-41_SOD81_P10.16mm_Horizontal.step, D_SMA.step, ESP32-S3-WROOM-1.step, JST_EH_B2B-EH-A_1x02_P2.50mm_Vertical.step]
2026-08-29 - Changed comment on page 2 - Fixed Q2B PMOS connections (Li mortacci mia!)
    [Weather Station V2.kicad_pcb, Weather Station V2.kicad_sch, sensors_interface.kicad_sch]
2026-10-01 - Fixed SCL SDA swap on breakout pins - Added wind speed test point - Regenerated all boards' stiching vias - Fixed wrong pullup on secondary board WSPEED pin (5V --> 3V3)
    [3.3V LDO Regulator, CJMCU-680, BME680 Ambient Temperature, Relative Humidity, Barometric Pressure, and Gas VOC Sensor.SLDPRT, 8 Legs SMD Component, CJMCU-680, BME680 Ambient Temperature, Relative Humidity, Barometric Pressure, and Gas VOC Sensor.SLDPRT, AS5600.step, Adafruit VEML 7700 Light Sensor Breakout Board.SLDPRT, Adafruit VEML 7700 Light Sensor Breakout Board.STEP, AnemoFlyer.stl, AnemoFly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]
