TheMiz1os/WeatherStationV2/(notices)

Notices in the files:
3D Models/C_1206_3216Metric.step:
Copyright (C) 2017, kicad StepUp
This work is licensed under the [Creative Commons CC-BY-SA 4.0 License](https://creativecommons.org/licenses/by-sa/4.0/legalcode),
with the following exception:
To the extent that the creation of electronic designs that use 'Licensed Material' can be considered to be 'Adapted Material',
You are free to use the library data in your own projects without the obligation to share your project files under this or any other license agreement.
3D Models/CP_Radial_D4.0mm_P1.50mm.step:
This program is free software: you can redistribute it and/or modify
it under the terms of the GNU General Public License as published by
the Free Software Foundation, either version 3 of the License, or
any later version.
itself might be covered by the GNU General Public License.
3D Models/LED_1206_3216Metric.step:
Copyright (C) 2018, kicad StepUp
3D Models/JST_EH_B2B-EH-A_1x02_P2.50mm_Vertical.step:
Copyright (C) 2019, Rene Poeschl
3D Models/SOT-23-6.step:
Copyright (C) 2025, KiCAD
This work is licensed under the
[Creative Commons CC-BY-SA 4.0 License](https://creativecommons.org/licenses/by-sa/4.0/legalcode),
project files under this or any other license agreement. However, if you wish to distribute
3D Models/PinSocket_1x05_P2.54mm_Vertical.step:
Copyright (C) 2024, KiCAD
